LateToTheGame16/InGameNES/ingameNES_back.png

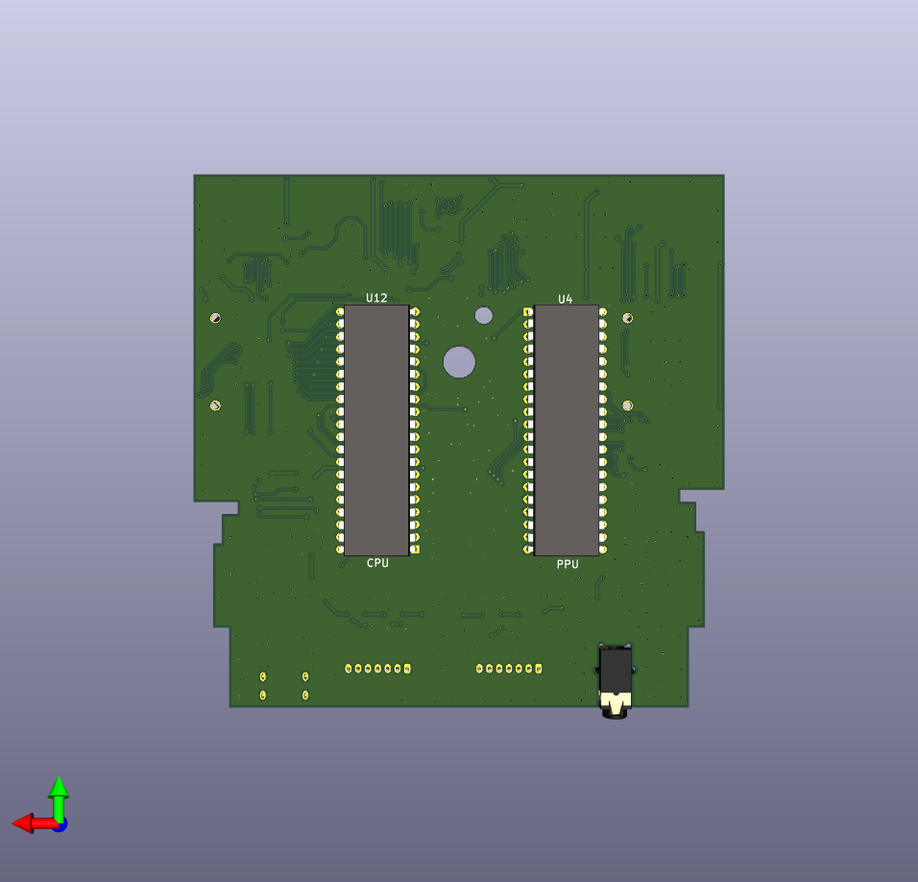
ingameNES_back.png
