LateToTheGame16/InGameNES/ingameNES.png

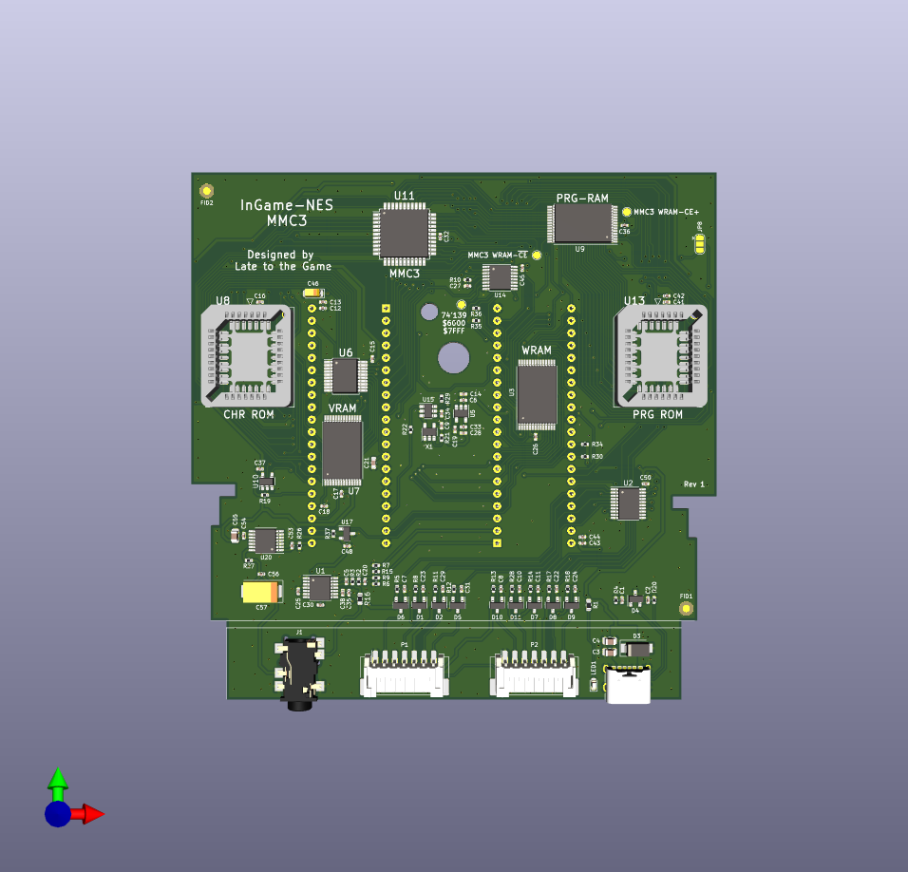
ingameNES.png
