LateToTheGame16/InGameNES/README.md

# InGameNES
 NES console that fits in a game cart
