LateToTheGame16/InGameNES/PTS847MM350LSMTR2 LFS.stp

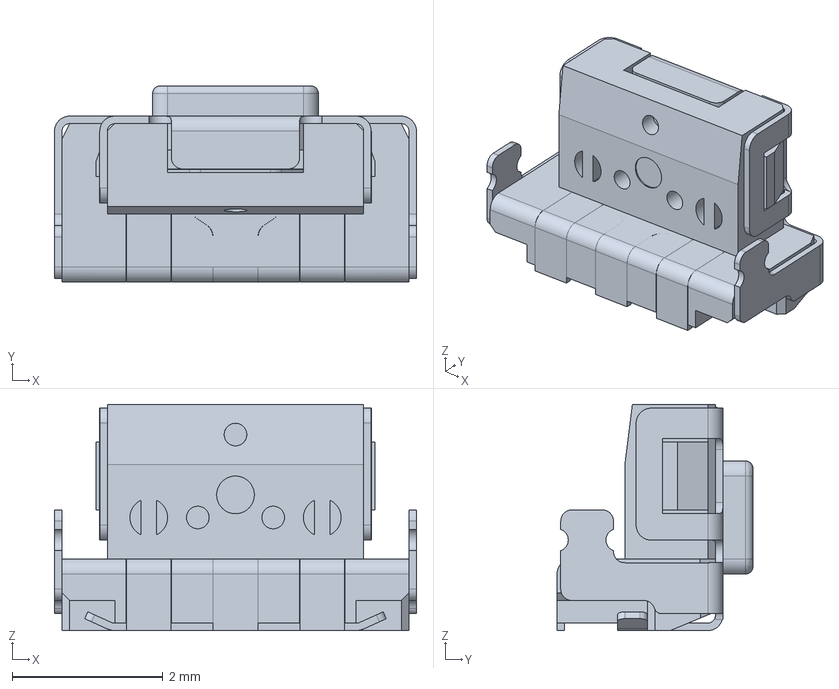
[picture p3: CAD file, 2022-07-29]
PTS847MM350LSMTR2 LFS.stp
4.80 x 2.60 x 3.00 mm
