LateToTheGame16/InGameNES/L_XNH8080YK.STEP

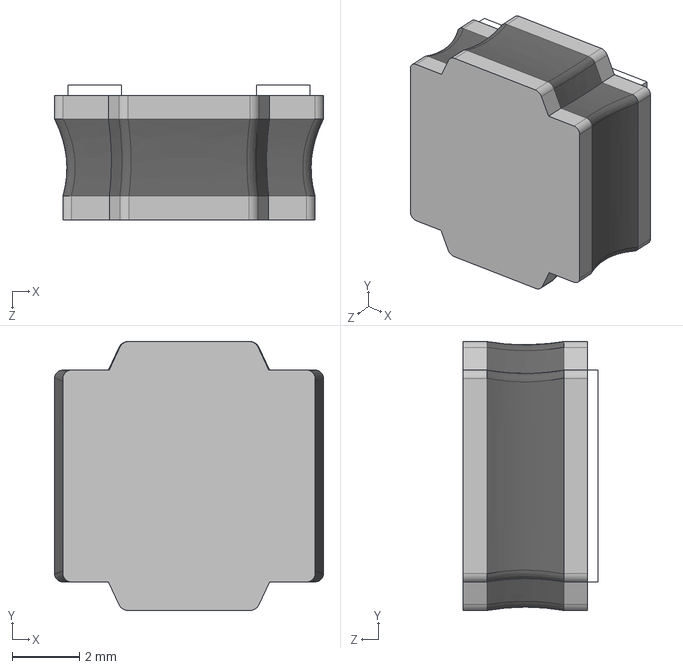
[picture p4: CAD file, 2022-07-29]
L_XNH8080YK.STEP
8.00 x 8.00 x 4.00 mm
