LateToTheGame16/InGameNES/CUI_UJC-HP-3-SMT-TR.step

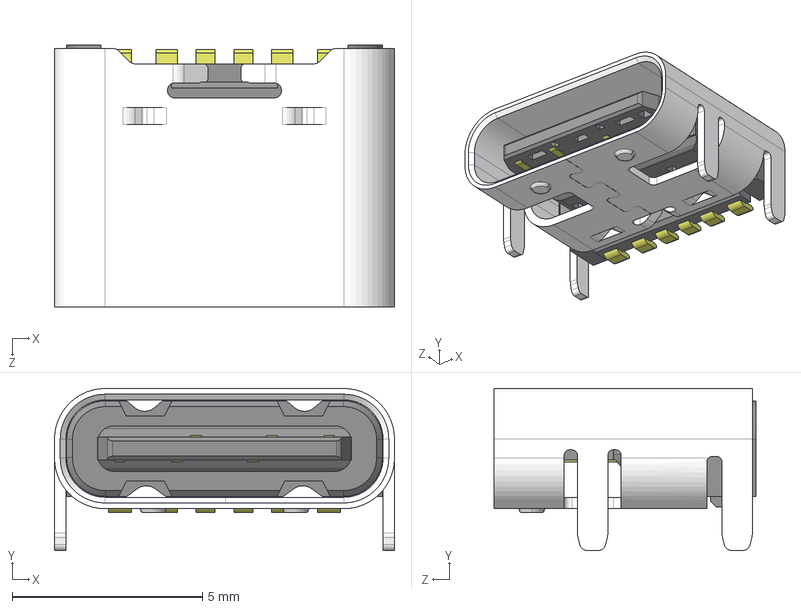
[picture p5: CAD file, 2022-06-28]
CUI_UJC-HP-3-SMT-TR.step
8.94 x 4.26 x 6.90 mm
