LateToTheGame16/InGameNES/8432-21a1-01.stp

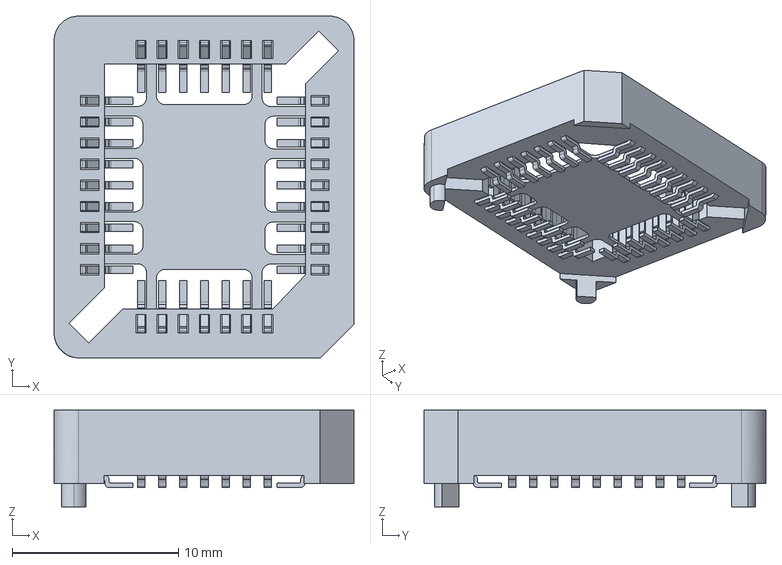
[picture p6: CAD file, 2022-06-28]
8432-21a1-01.stp
18.0 x 20.5 x 5.82 mm
