LateToTheGame16/InGameNES/CUI_DEVICES_SJ-43504-SMT-TR.step

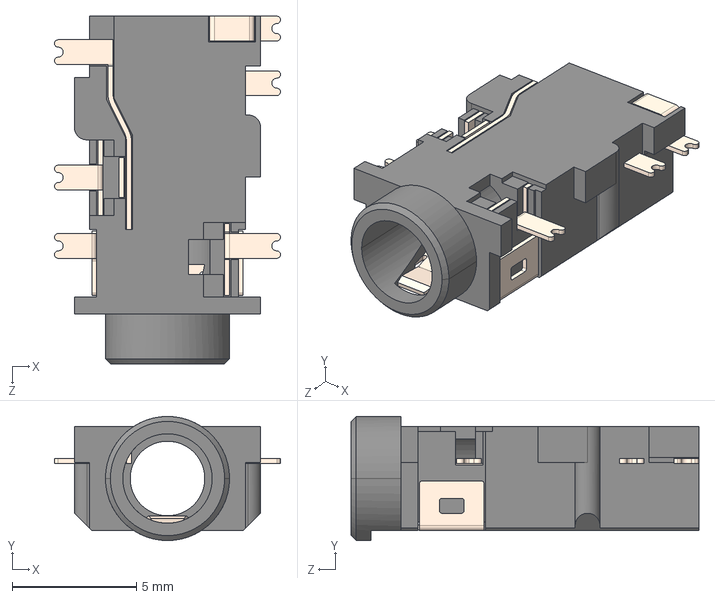
[picture p7: CAD file, 2022-06-28]
CUI_DEVICES_SJ-43504-SMT-TR.step
9.10 x 5.00 x 14.0 mm
