LateToTheGame16/InGameNES/ingameNES.kicad_pcb

## KiCad design ingameNES.kicad_pcb (2022-06-28)

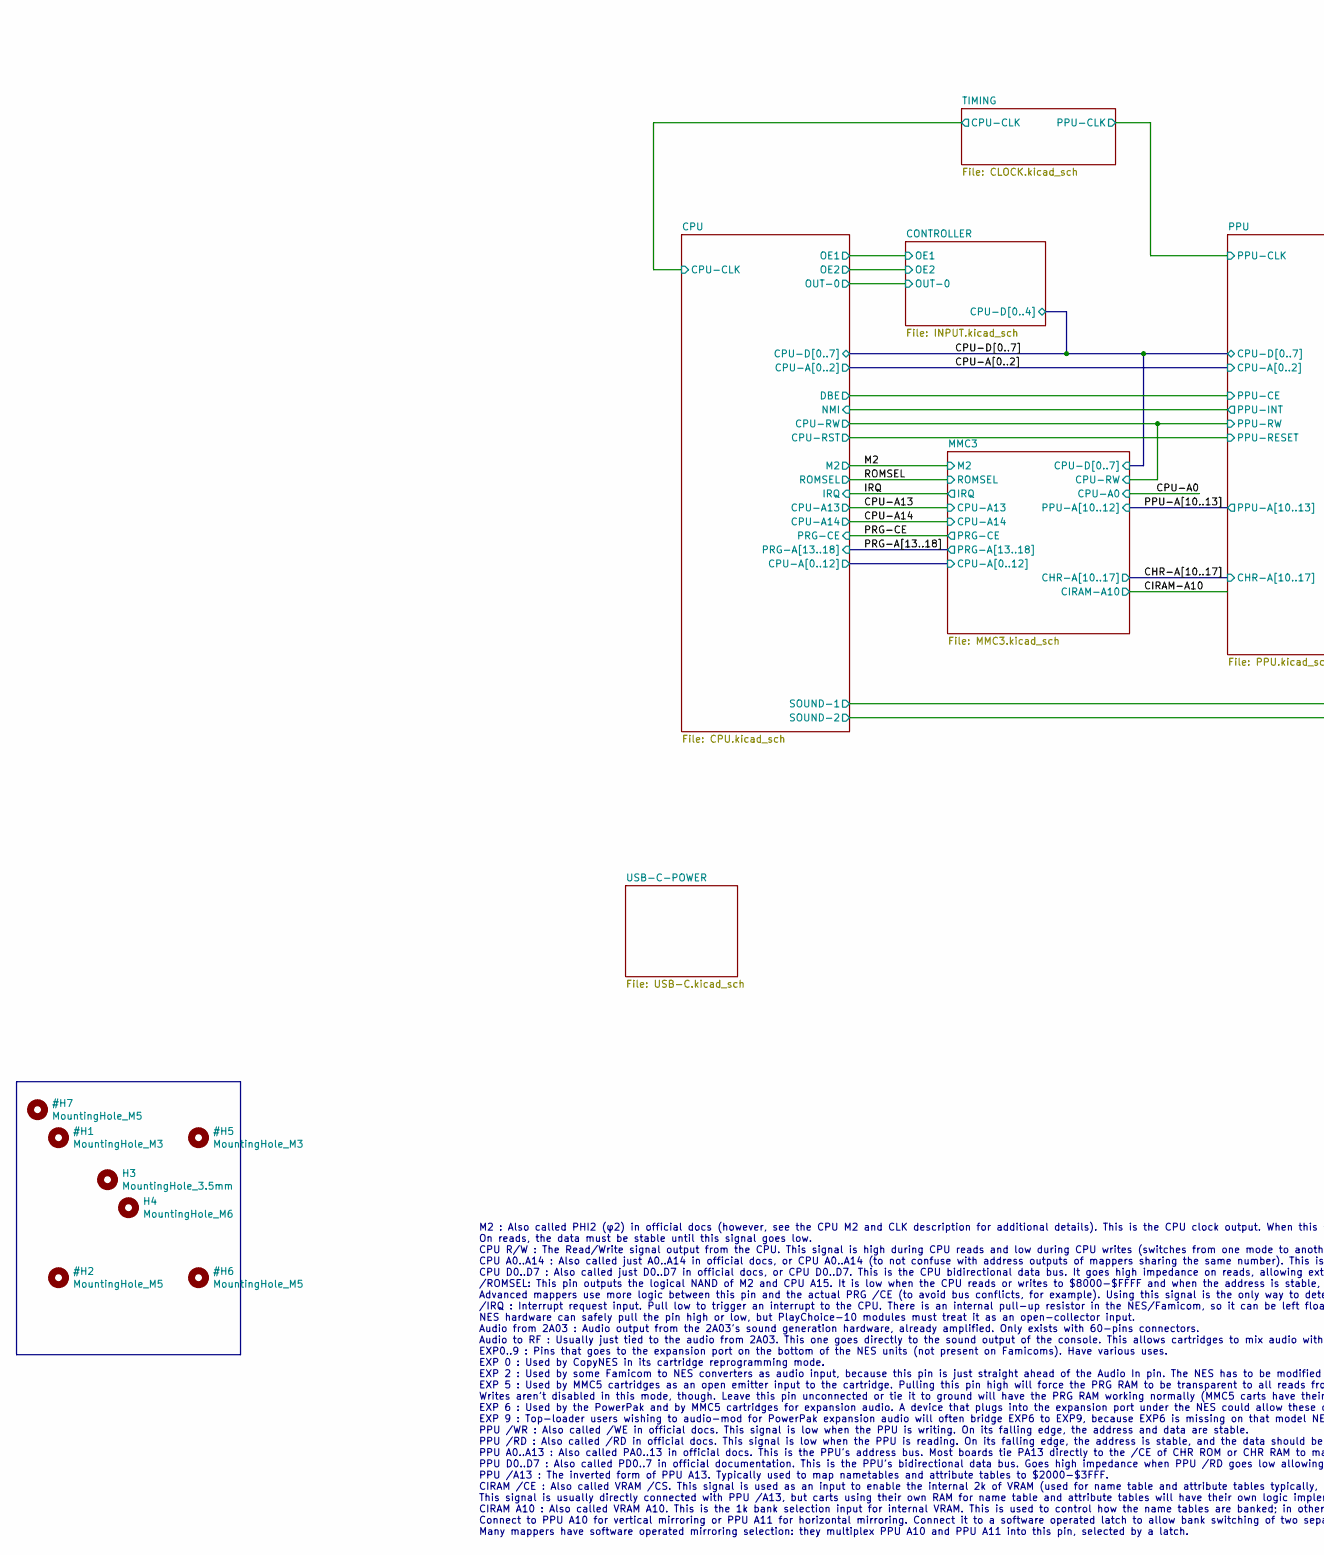
[picture p8: schematic ingameNES.kicad_sch, InGame-NES MMC3, part in row 1, column 1]

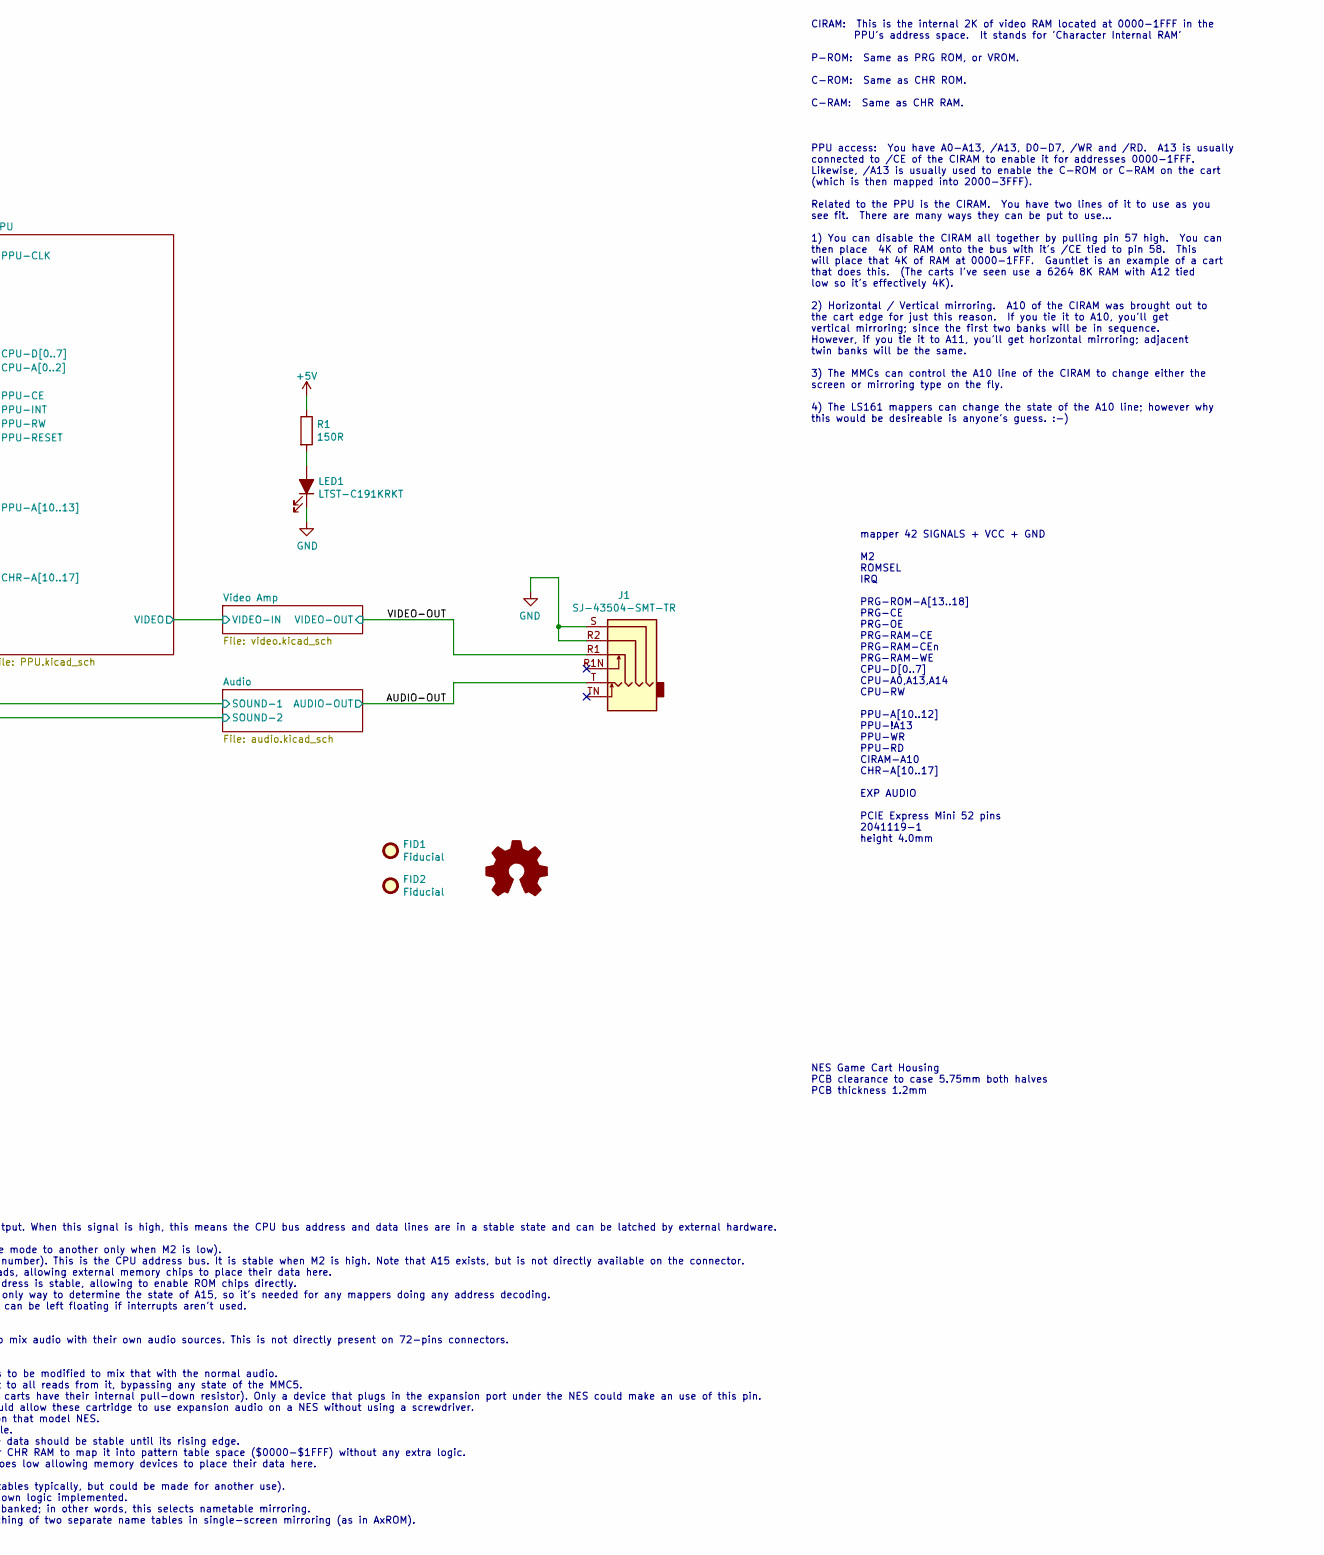
[picture p9: schematic ingameNES.kicad_sch, InGame-NES MMC3, part in row 1, column 2]

Parts:
FID1, FID2: Fiducial; Fiducial_1.5mm_Mask3mm
H3: MountingHole_3.5mm
H4: MountingHole_M6; MountingHole_6.4mm_M6
J1: SJ-43504-SMT-TR; CUI_SJ-43504-SMT-TR; MPN SJ-43504-SMT-TR; Digikey CP-43504SJCT-ND
LED1: LTST-C191KRKT; LED_0603_1608Metric; MPN LTST-C191KRKT; Digikey 160-1447-1-ND
R1: 150R; R_0603_1608Metric; MPN RC0603FR-07150RL; Digikey 311-150HRCT-ND

Connections:
/AUDIO-OUT: J1.T; also elsewhere on the board
/VIDEO-OUT: J1.R1; also elsewhere on the board
unnamed: LED1.2 (A), R1.2

Notes on the sheet:
mapper 42 SIGNALS + VCC + GND M2 ROMSEL IRQ PRG-ROM-A[13..18] PRG-CE PRG-OE PRG-RAM-CE PRG-RAM-CEn PRG-RAM-WE CPU-D[0..7] CPU-A0,A13,A14 CPU-RW PPU-A[10..12] PPU-!A13 PPU-WR PPU-RD CIRAM-A10 CHR-A[10..17] EXP AUDIO PCIE Express Mini 52 pins 2041119-1 height 4.0mm
CIRAM: This is the internal 2K of video RAM located at 0000-1FFF in the PPU's address space. It stands for 'Character Internal RAM' P-ROM: Same as PRG ROM, or VROM. C-ROM: Same as CHR ROM. C-RAM: Same as CHR RAM. PPU access: You have A0-A13, /A13, D0-D7, /WR and /RD. A13 is usually connected to /CE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
M2 : Also called PHI2 (φ2) in official docs (however, see the CPU M2 and CLK description for additional details). This is the CPU clock output. When this signal is high, this means the CPU bus address and data lines are in a stable state and can be latched by external hardware. On reads, the data m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
NES Game Cart Housing PCB clearance to case 5.75mm both halves PCB thickness 1.2mm

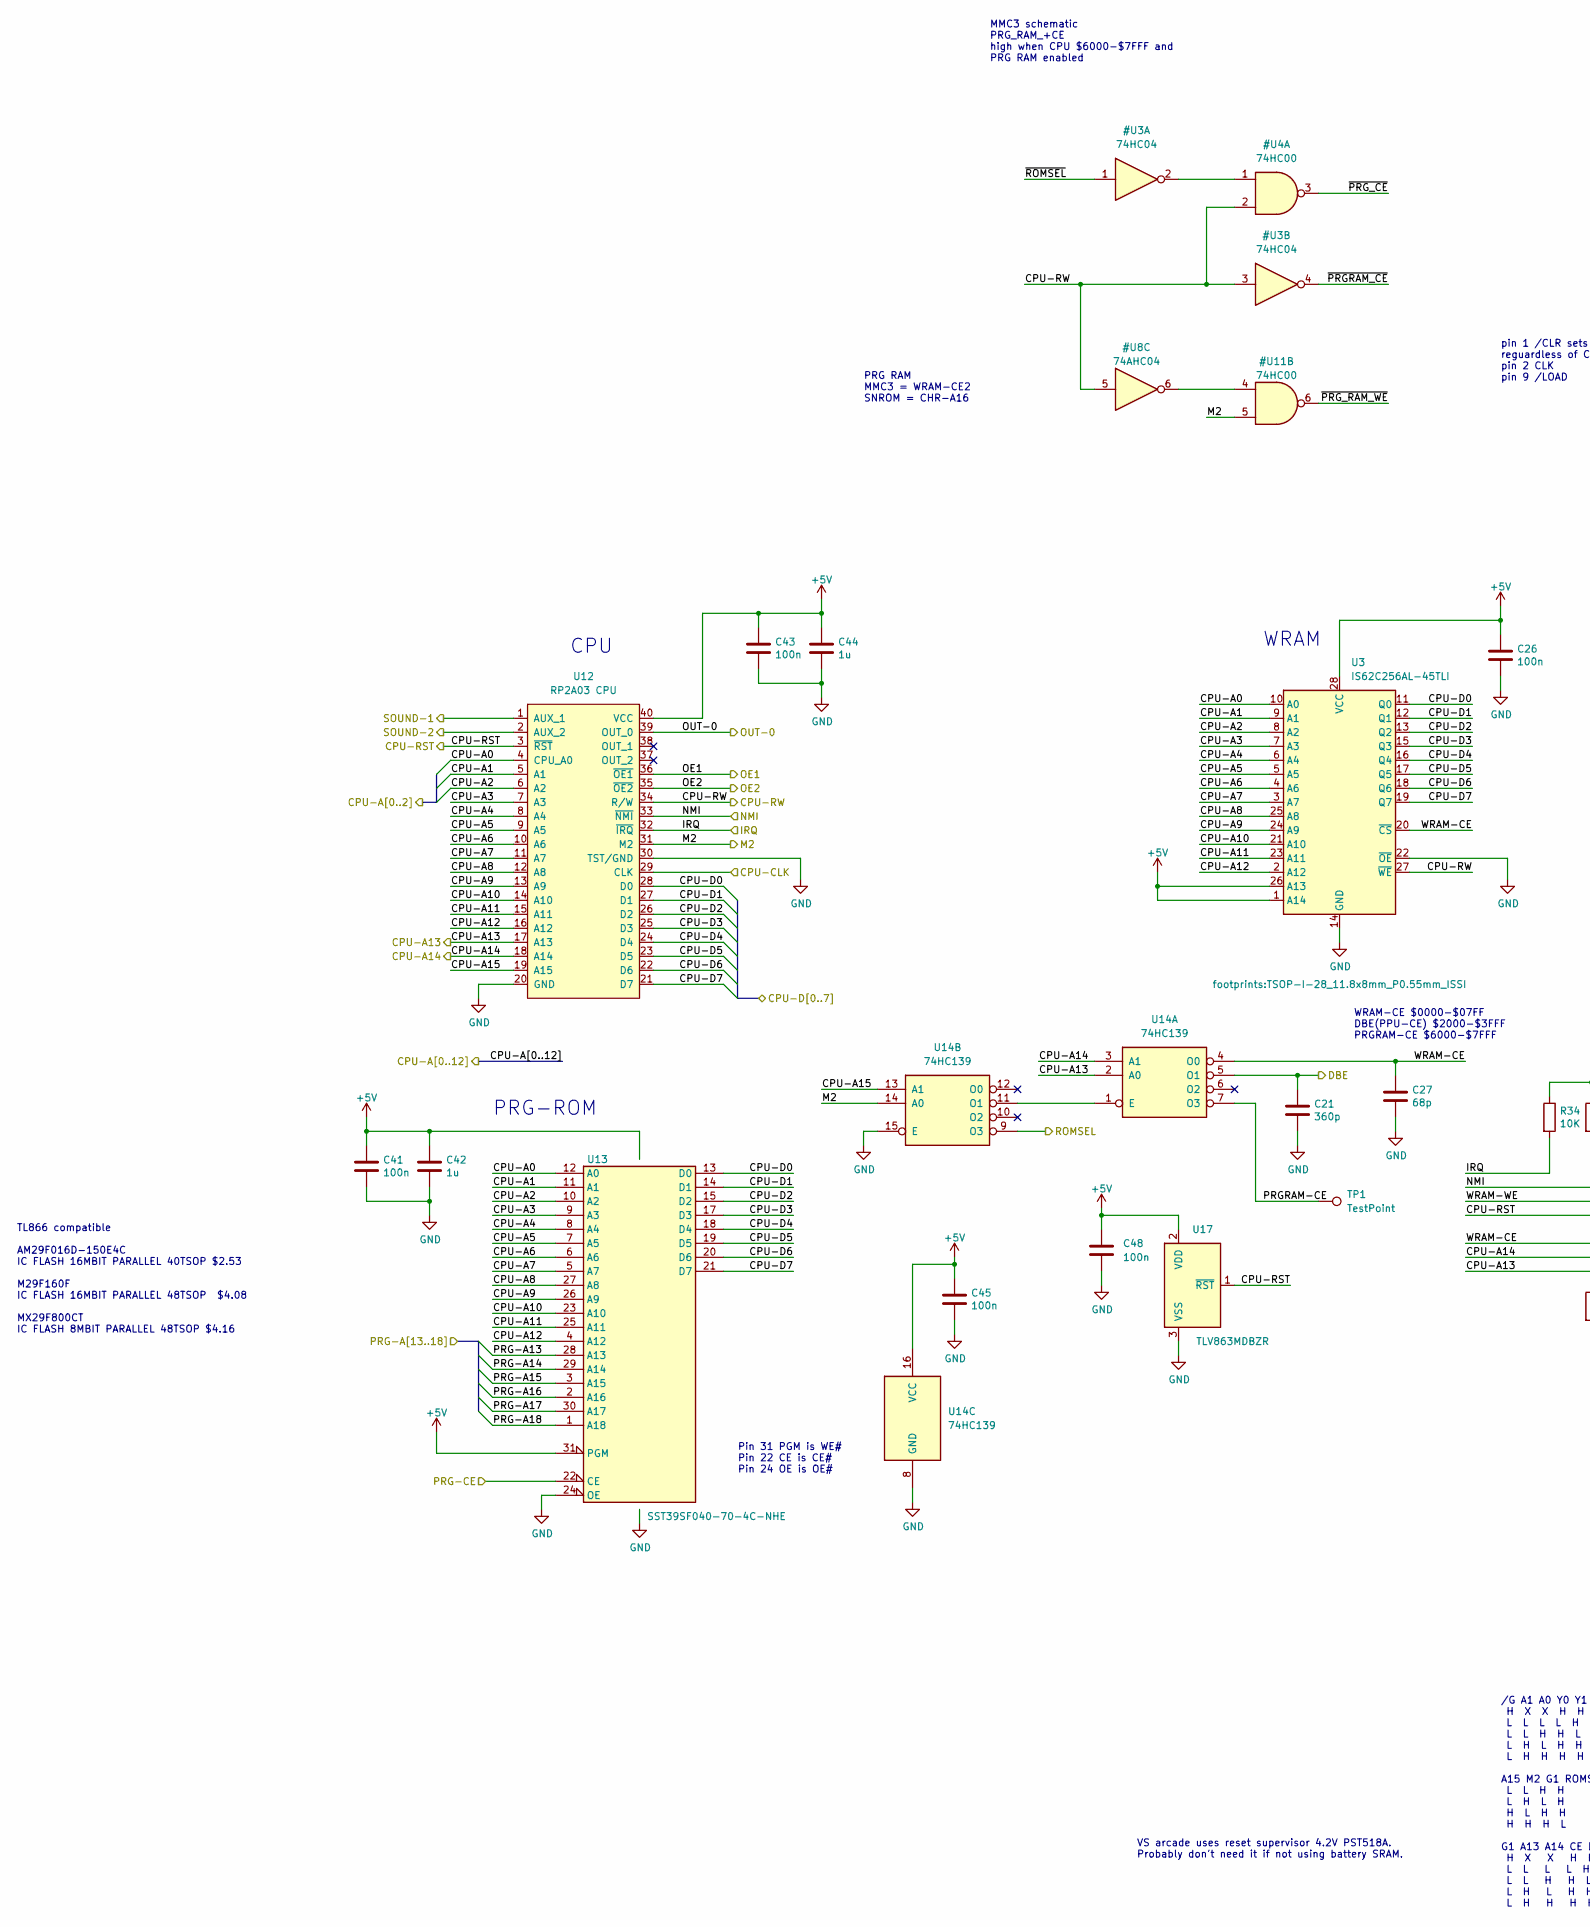
[picture p10: schematic CPU.kicad_sch, InGame-NES MMC3, part in row 1, column 1]

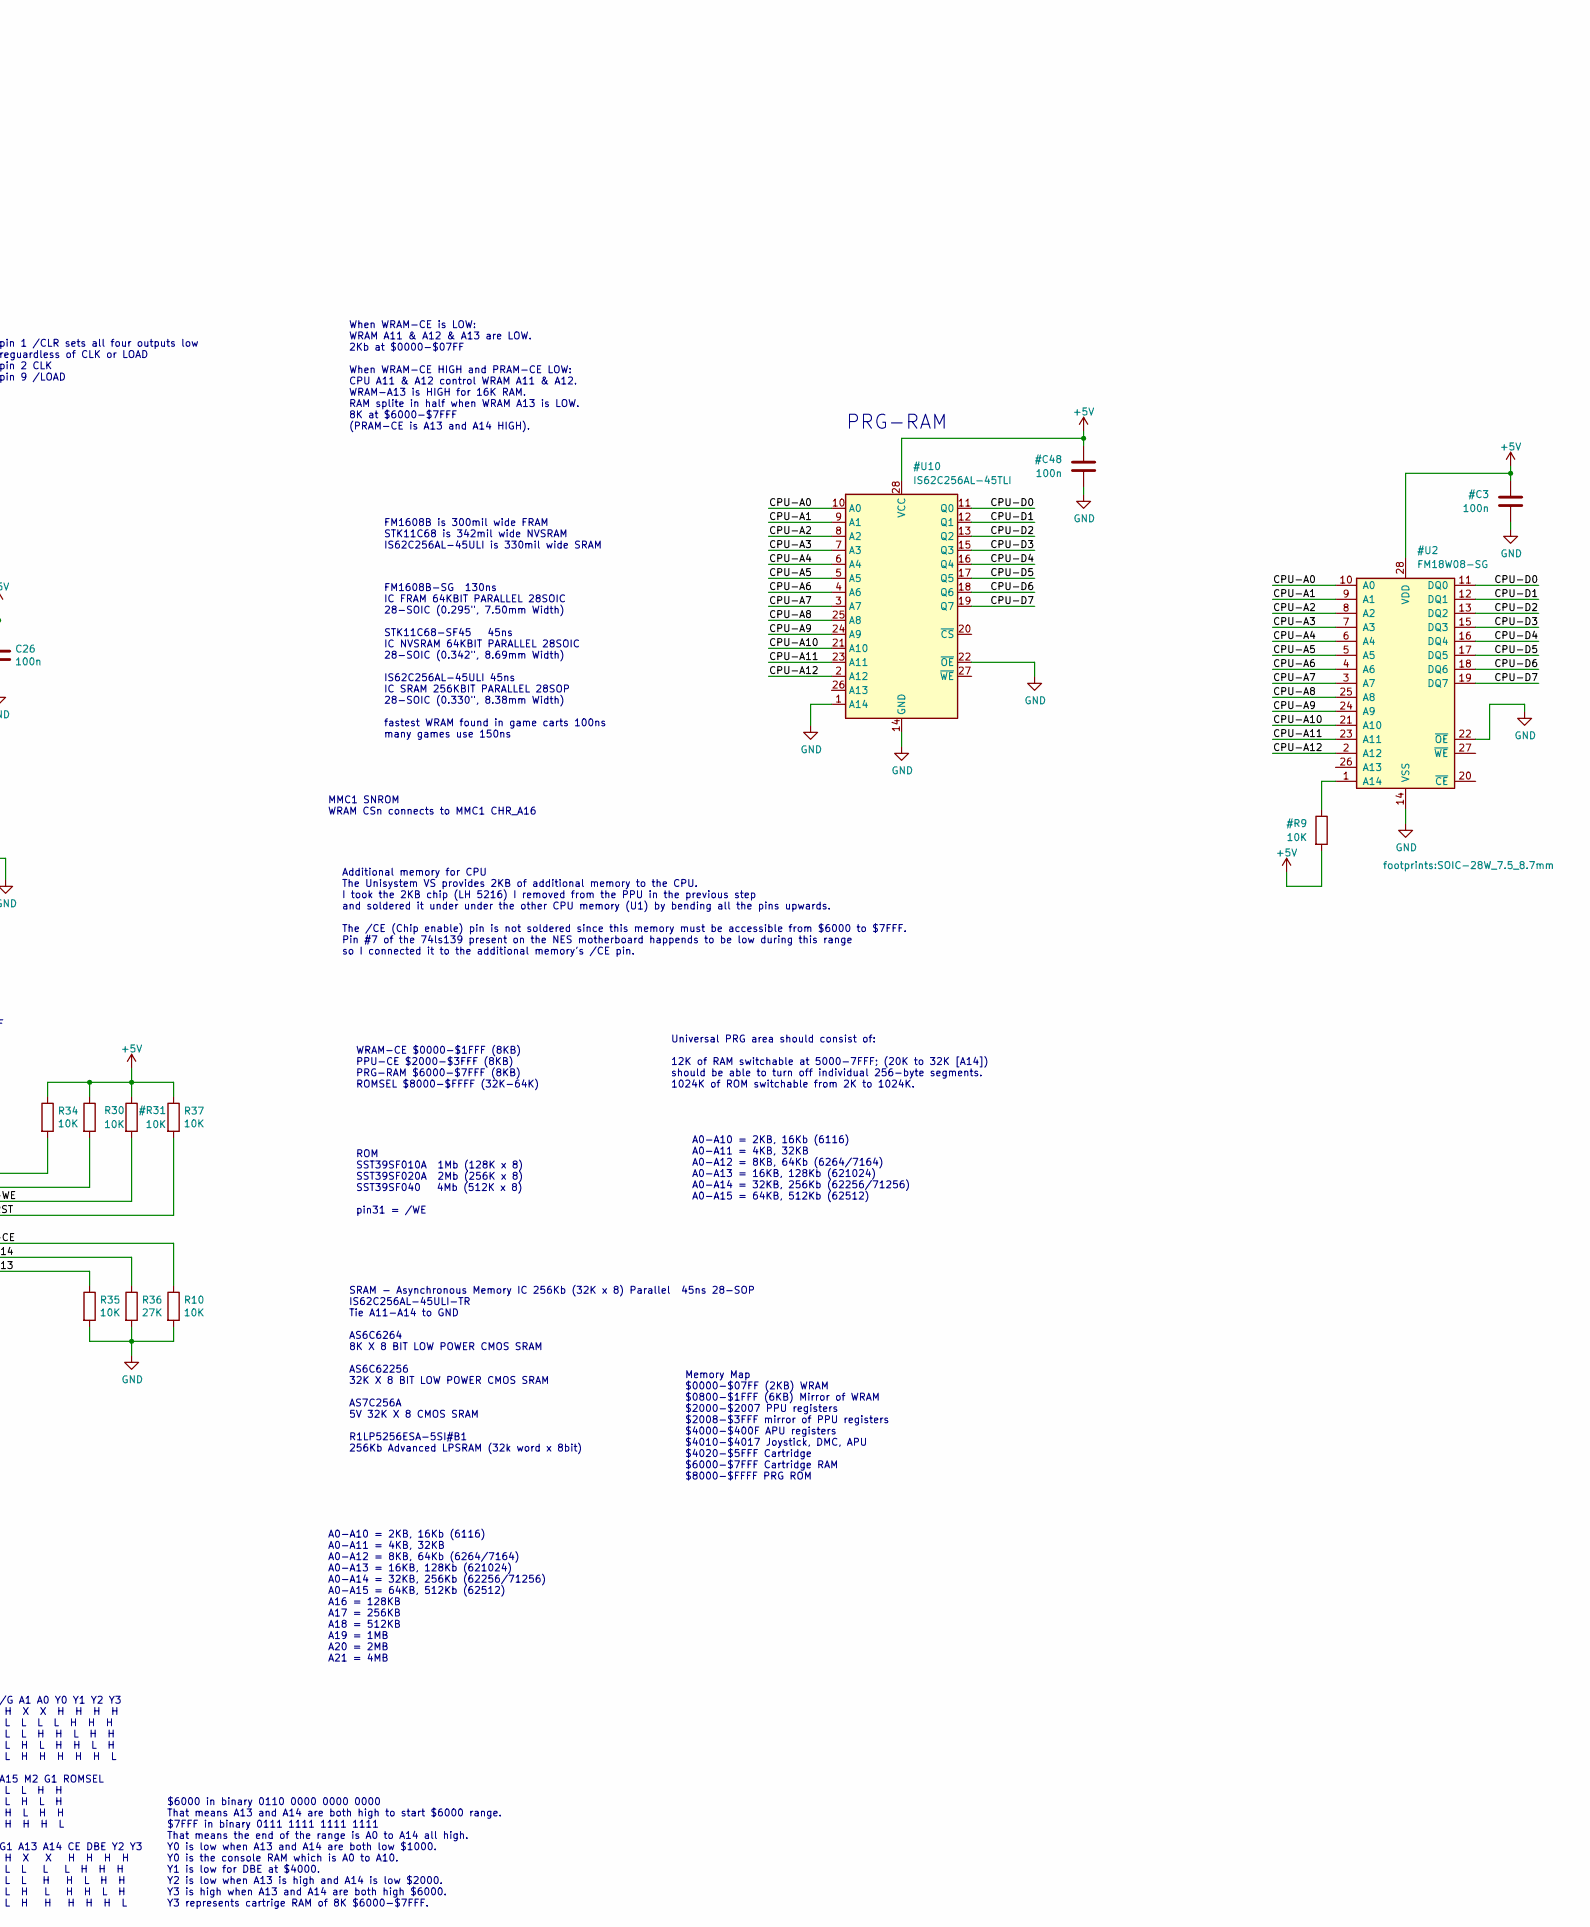
[picture p11: schematic CPU.kicad_sch, InGame-NES MMC3, part in row 1, column 2]

Parts:
C21: 360p; C_0603_1608Metric; MPN C0603C361J5GAC7867; Digikey 399-15397-1-ND
C26, C41, C43, C45, C48: 100n; C_0402_1005Metric; MPN CL05B104KO5NNWC; Digikey 1276-1509-2-ND
C27: 68p; C_0402_1005Metric; MPN CC0402JRNPO9BN680; Digikey 311-1340-1-ND
C42, C44: 1u; C_0402_1005Metric; MPN GRM155R61A105KE15D; Digikey 490-3890-2-ND
R10, R30, R34, R35, R37: 10K; R_0402_1005Metric; MPN ERJ-2RKF1002X; Digikey P10.0KLCT-ND
R36: 27K; R_0402_1005Metric; MPN RC0402JR-0727KL; Digikey 311-27KJRCT-ND
TP1: TestPoint; TestPoint_Pad_D1.5mm
U3: IS62C256AL-45TLI; TSOP-I-28_11.8x8mm_P0.55mm_ISSI; MPN IS62C256AL-45TLI; Digikey 706-1109-ND
U12: RP2A03 CPU; DIP-40_W15.24mm; MPN ED40DT; Digikey ED3048-5-ND
U13: SST39SF040-70-4C-NHE; SOCKET-PLCC-32-SMD; MPN SST39SF040-70-4C-NHE; Digikey SST39SF040-70-4C-NHE-ND
U14: 74HC139; TSSOP-16_4.4x5mm_P0.65mm; MPN SN74HC139PWR; Digikey 296-8231-1-ND
U17: TLV863MDBZR; SOT-23; MPN TLV863MDBZR; Digikey 296-29707-1-ND

Connections:
/Audio/SOUND-1: U12.1 (AUX_1); also elsewhere on the board
/Audio/SOUND-2: U12.2 (AUX_2); also elsewhere on the board
/CONTROLLER/OE1: U12.36 (~OE1); also elsewhere on the board
/CONTROLLER/OE2: U12.35 (~OE2); also elsewhere on the board
/CONTROLLER/OUT-0: U12.39 (OUT_0); also elsewhere on the board
/CPU/CPU-A15: U12.19 (A15), U14.13 (A1)
/CPU/CPU-RST: R37.2, U12.3 (~RST), U17.1 (~RST); also elsewhere on the board
/CPU/DBE: C21.2, U14.5 (O1); also elsewhere on the board
/CPU/NMI: R30.2, U12.33 (~NMI); also elsewhere on the board
/CPU/PRGRAM-CE: TP1.1, U14.7 (O3)
/CPU/WRAM-CE: C27.2, R10.1, U3.20 (~CS), U14.4 (O0)
unnamed: U14.1 (E), U14.11 (O1)

Notes on the sheet:
FM1608B-SG 130ns IC FRAM 64KBIT PARALLEL 28SOIC 28-SOIC (0.295", 7.50mm Width) STK11C68-SF45 45ns IC NVSRAM 64KBIT PARALLEL 28SOIC 28-SOIC (0.342", 8.69mm Width) IS62C256AL-45ULI 45ns IC SRAM 256KBIT PARALLEL 28SOP 28-SOIC (0.330", 8.38mm Width) fastest WRAM found in game carts 100ns many games use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
PRG RAM MMC3 = WRAM-CE2 SNROM = CHR-A16
PRG-ROM
CPU
TL866 compatible AM29F016D-150E4C IC FLASH 16MBIT PARALLEL 40TSOP $2.53 M29F160F IC FLASH 16MBIT PARALLEL 48TSOP $4.08 MX29F800CT IC FLASH 8MBIT PARALLEL 48TSOP $4.16
pin 1 /CLR sets all four outputs low reguardless of CLK or LOAD pin 2 CLK pin 9 /LOAD
Additional memory for CPU The Unisystem VS provides 2KB of additional memory to the CPU. I took the 2KB chip (LH 5216) I removed from the PPU in the previous step and soldered it under under the other CPU memory (U1) by bending all the pins upwards. The /CE (Chip enable) pin is not soldered since t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
ROM SST39SF010A 1Mb (128K x 8) SST39SF020A 2Mb (256K x 8) SST39SF040 4Mb (512K x 8) pin31 = /WE
Memory Map $0000-$07FF (2KB) WRAM $0800-$1FFF (6KB) Mirror of WRAM $2000-$2007 PPU registers $2008-$3FFF mirror of PPU registers $4000-$400F APU registers $4010-$4017 Joystick, DMC, APU $4020-$5FFF Cartridge $6000-$7FFF Cartridge RAM $8000-$FFFF PRG ROM
Pin 31 PGM is WE# Pin 22 CE is CE# Pin 24 OE is OE#
VS arcade uses reset supervisor 4.2V PST518A. Probably don't need it if not using battery SRAM.
PRG-RAM
Universal PRG area should consist of: 12K of RAM switchable at 5000-7FFF; (20K to 32K [A14]) should be able to turn off individual 256-byte segments. 1024K of ROM switchable from 2K to 1024K.
WRAM-CE $0000-$07FF DBE(PPU-CE) $2000-$3FFF PRGRAM-CE $6000-$7FFF
$6000 in binary 0110 0000 0000 0000 That means A13 and A14 are both high to start $6000 range. $7FFF in binary 0111 1111 1111 1111 That means the end of the range is A0 to A14 all high. Y0 is low when A13 and A14 are both low $1000. Y0 is the console RAM which is A0 to A10. Y1 is low for DBE at $40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
When WRAM-CE is LOW: WRAM A11 & A12 & A13 are LOW. 2Kb at $0000-$07FF When WRAM-CE HIGH and PRAM-CE LOW: CPU A11 & A12 control WRAM A11 & A12. WRAM-A13 is HIGH for 16K RAM. RAM splite in half when WRAM A13 is LOW. 8K at $6000-$7FFF (PRAM-CE is A13 and A14 HIGH).
WRAM
SRAM - Asynchronous Memory IC 256Kb (32K x 8) Parallel 45ns 28-SOP IS62C256AL-45ULI-TR Tie A11-A14 to GND AS6C6264 8K X 8 BIT LOW POWER CMOS SRAM AS6C62256 32K X 8 BIT LOW POWER CMOS SRAM AS7C256A 5V 32K X 8 CMOS SRAM R1LP5256ESA-5SI#B1 256Kb Advanced LPSRAM (32k word x 8bit)
MMC3 schematic PRG_RAM_+CE high when CPU $6000-$7FFF and PRG RAM enabled
FM1608B is 300mil wide FRAM STK11C68 is 342mil wide NVSRAM IS62C256AL-45ULI is 330mil wide SRAM
WRAM-CE $0000-$1FFF (8KB) PPU-CE $2000-$3FFF (8KB) PRG-RAM $6000-$7FFF (8KB) ROMSEL $8000-$FFFF (32K-64K)
/G A1 A0 Y0 Y1 Y2 Y3 H X X H H H H L L L L H H H L L H H L H H L H L H H L H L H H H H H L A15 M2 G1 ROMSEL L L H H L H L H H L H H H H H L G1 A13 A14 CE DBE Y2 Y3 H X X H H H H L L L L H H H L L H H L H H L H L H H L H L H H H H H L
A0-A10 = 2KB, 16Kb (6116) A0-A11 = 4KB, 32KB A0-A12 = 8KB, 64Kb (6264/7164) A0-A13 = 16KB, 128Kb (621024) A0-A14 = 32KB, 256Kb (62256/71256) A0-A15 = 64KB, 512Kb (62512) A16 = 128KB A17 = 256KB A18 = 512KB A19 = 1MB A20 = 2MB A21 = 4MB
A0-A10 = 2KB, 16Kb (6116) A0-A11 = 4KB, 32KB A0-A12 = 8KB, 64Kb (6264/7164) A0-A13 = 16KB, 128Kb (621024) A0-A14 = 32KB, 256Kb (62256/71256) A0-A15 = 64KB, 512Kb (62512)
MMC1 SNROM WRAM CSn connects to MMC1 CHR_A16

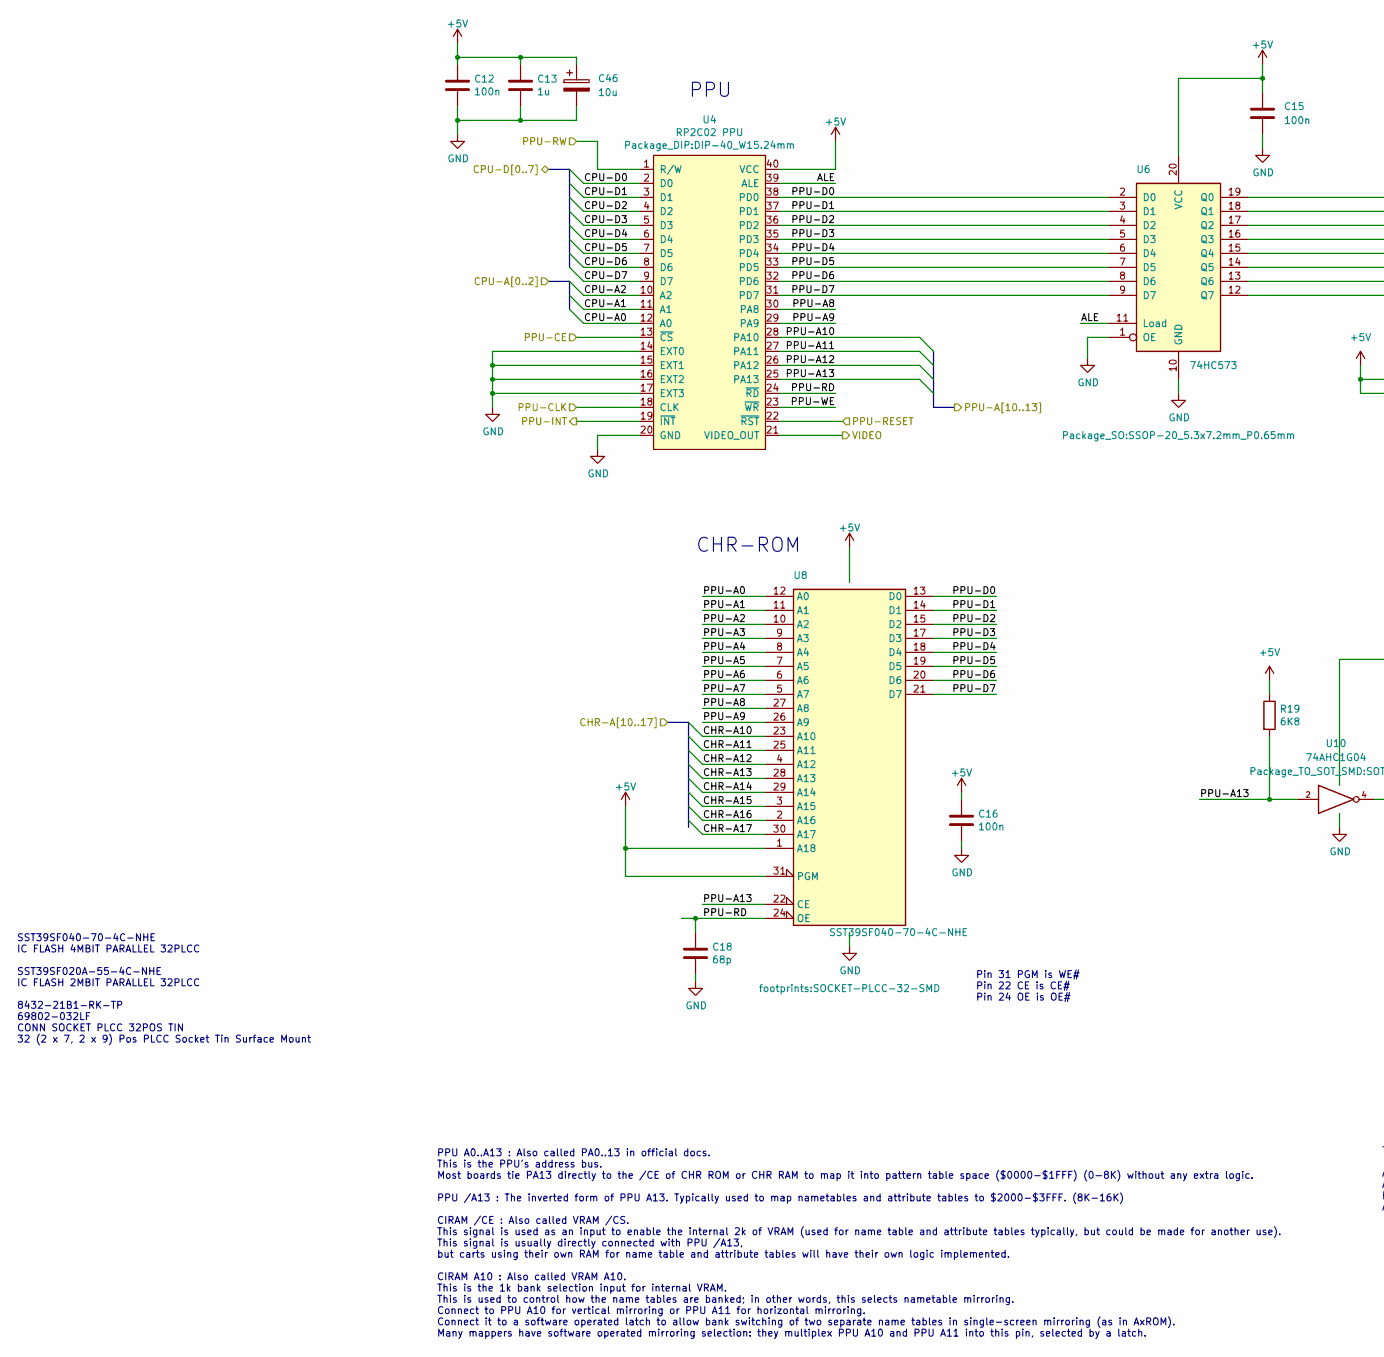
[picture p12: schematic PPU.kicad_sch, InGame-NES MMC3, part in row 1, column 1]

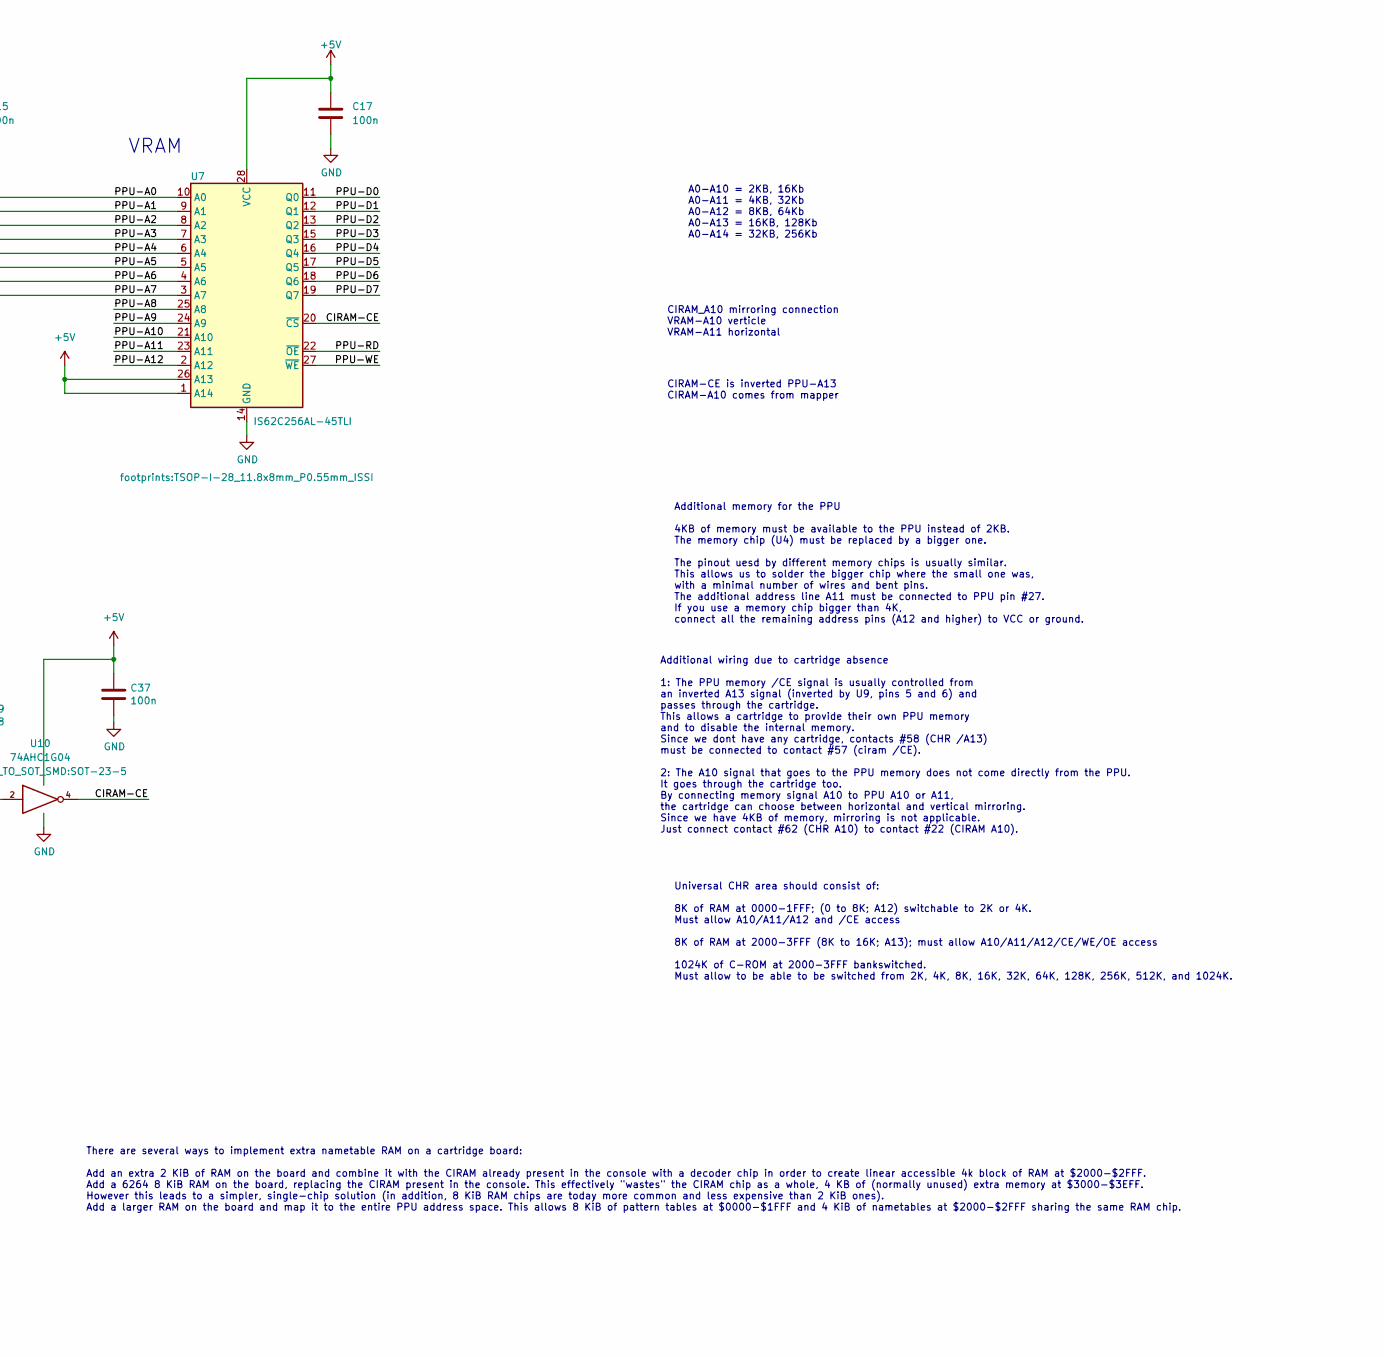
[picture p13: schematic PPU.kicad_sch, InGame-NES MMC3, part in row 1, column 2]

Parts:
C12, C15, C16, C17, C37: 100n; C_0402_1005Metric; MPN CL05B104KO5NNWC; Digikey 1276-1509-2-ND
C13: 1u; C_0402_1005Metric; MPN GRM155R61A105KE15D; Digikey 490-3890-2-ND
C18: 68p; C_0402_1005Metric; MPN CC0402JRNPO9BN680; Digikey 311-1340-1-ND
C46: 10u; CP_EIA-3216-18_Kemet-A; MPN T491A106K010AT; Digikey 399-3684-1-ND
R19: 6K8; R_0402_1005Metric; MPN RC0402FR-076K8L; Digikey 311-6.80KLRCT-ND
U4: RP2C02 PPU; DIP-40_W15.24mm; MPN ED40DT; Digikey ED3048-5-ND
U6: 74HC573; SSOP-20_5.3x7.2mm_P0.65mm; MPN SN74HC573ADBR; Digikey 296-SN74HC573ADBRCT-ND
U7: IS62C256AL-45TLI; TSOP-I-28_11.8x8mm_P0.55mm_ISSI; MPN IS62C256AL-45TLI; Digikey 706-1109-ND
U8: SST39SF040-70-4C-NHE; SOCKET-PLCC-32-SMD; MPN SST39SF040-70-4C-NHE; Digikey SST39SF040-70-4C-NHE-ND
U10: 74AHC1G04; SOT-23-5; MPN SN74AHC1G04DBVR; Digikey 296-1089-1-ND

Connections:
/CPU/CPU-RST: U4.22 (~RST); also elsewhere on the board
/CPU/DBE: U4.13 (~CS); also elsewhere on the board
/CPU/NMI: U4.19 (~INT); also elsewhere on the board
/PPU-A13: R19.2, U4.25 (PA13), U8.22 (CE), U10.2
/PPU/ALE: U4.39 (ALE), U6.11 (Load)
/PPU/CIRAM-CE: U7.20 (~CS), U10.4
/PPU/PPU-A0: U6.19 (Q0), U7.10 (A0), U8.12 (A0)
/PPU/PPU-A1: U6.18 (Q1), U7.9 (A1), U8.11 (A1)
/PPU/PPU-A2: U6.17 (Q2), U7.8 (A2), U8.10 (A2)
/PPU/PPU-A3: U6.16 (Q3), U7.7 (A3), U8.9 (A3)
/PPU/PPU-A4: U6.15 (Q4), U7.6 (A4), U8.8 (A4)
/PPU/PPU-A5: U6.14 (Q5), U7.5 (A5), U8.7 (A5)
/PPU/PPU-A6: U6.13 (Q6), U7.4 (A6), U8.6 (A6)
/PPU/PPU-A7: U6.12 (Q7), U7.3 (A7), U8.5 (A7)
/PPU/PPU-A8: U4.30 (PA8), U7.25 (A8), U8.27 (A8)
/PPU/PPU-A9: U4.29 (PA9), U7.24 (A9), U8.26 (A9)
/PPU/PPU-D0: U4.38 (PD0), U6.2 (D0), U7.11 (Q0), U8.13 (D0)
/PPU/PPU-D1: U4.37 (PD1), U6.3 (D1), U7.12 (Q1), U8.14 (D1)
/PPU/PPU-D2: U4.36 (PD2), U6.4 (D2), U7.13 (Q2), U8.15 (D2)
/PPU/PPU-D3: U4.35 (PD3), U6.5 (D3), U7.15 (Q3), U8.17 (D3)
/PPU/PPU-D4: U4.34 (PD4), U6.6 (D4), U7.16 (Q4), U8.18 (D4)
/PPU/PPU-D5: U4.33 (PD5), U6.7 (D5), U7.17 (Q5), U8.19 (D5)
/PPU/PPU-D6: U4.32 (PD6), U6.8 (D6), U7.18 (Q6), U8.20 (D6)
/PPU/PPU-D7: U4.31 (PD7), U6.9 (D7), U7.19 (Q7), U8.21 (D7)
/PPU/PPU-RD: C18.2, U4.24 (~RD), U7.22 (~OE), U8.24 (OE)
/PPU/PPU-WE: U4.23 (~WR), U7.27 (~WE)
/PPU/VIDEO: U4.21 (VIDEO_OUT); also elsewhere on the board

Notes on the sheet:
SST39SF040-70-4C-NHE IC FLASH 4MBIT PARALLEL 32PLCC SST39SF020A-55-4C-NHE IC FLASH 2MBIT PARALLEL 32PLCC 8432-21B1-RK-TP 69802-032LF CONN SOCKET PLCC 32POS TIN 32 (2 x 7, 2 x 9) Pos PLCC Socket Tin Surface Mount
A0-A10 = 2KB, 16Kb A0-A11 = 4KB, 32Kb A0-A12 = 8KB, 64Kb A0-A13 = 16KB, 128Kb A0-A14 = 32KB, 256Kb
Additional wiring due to cartridge absence 1: The PPU memory /CE signal is usually controlled from an inverted A13 signal (inverted by U9, pins 5 and 6) and passes through the cartridge. This allows a cartridge to provide their own PPU memory and to disable the internal memory. Since we dont have a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
CIRAM_A10 mirroring connection VRAM-A10 verticle VRAM-A11 horizontal
Additional memory for the PPU 4KB of memory must be available to the PPU instead of 2KB. The memory chip (U4) must be replaced by a bigger one. The pinout uesd by different memory chips is usually similar. This allows us to solder the bigger chip where the small one was, with a minimal number of wi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
CHR-ROM
Universal CHR area should consist of: 8K of RAM at 0000-1FFF; (0 to 8K; A12) switchable to 2K or 4K. Must allow A10/A11/A12 and /CE access 8K of RAM at 2000-3FFF (8K to 16K; A13); must allow A10/A11/A12/CE/WE/OE access 1024K of C-ROM at 2000-3FFF bankswitched. Must allow to be able to be switched f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
PPU A0..A13 : Also called PA0..13 in official docs. This is the PPU's address bus. Most boards tie PA13 directly to the /CE of CHR ROM or CHR RAM to map it into pattern table space ($0000-$1FFF) (0-8K) without any extra logic. PPU /A13 : The inverted form of PPU A13. Typically used to map nametable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
There are several ways to implement extra nametable RAM on a cartridge board: Add an extra 2 KiB of RAM on the board and combine it with the CIRAM already present in the console with a decoder chip in order to create linear accessible 4k block of RAM at $2000-$2FFF. Add a 6264 8 KiB RAM on the boar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
CIRAM-CE is inverted PPU-A13 CIRAM-A10 comes from mapper
PPU
VRAM
Pin 31 PGM is WE# Pin 22 CE is CE# Pin 24 OE is OE#

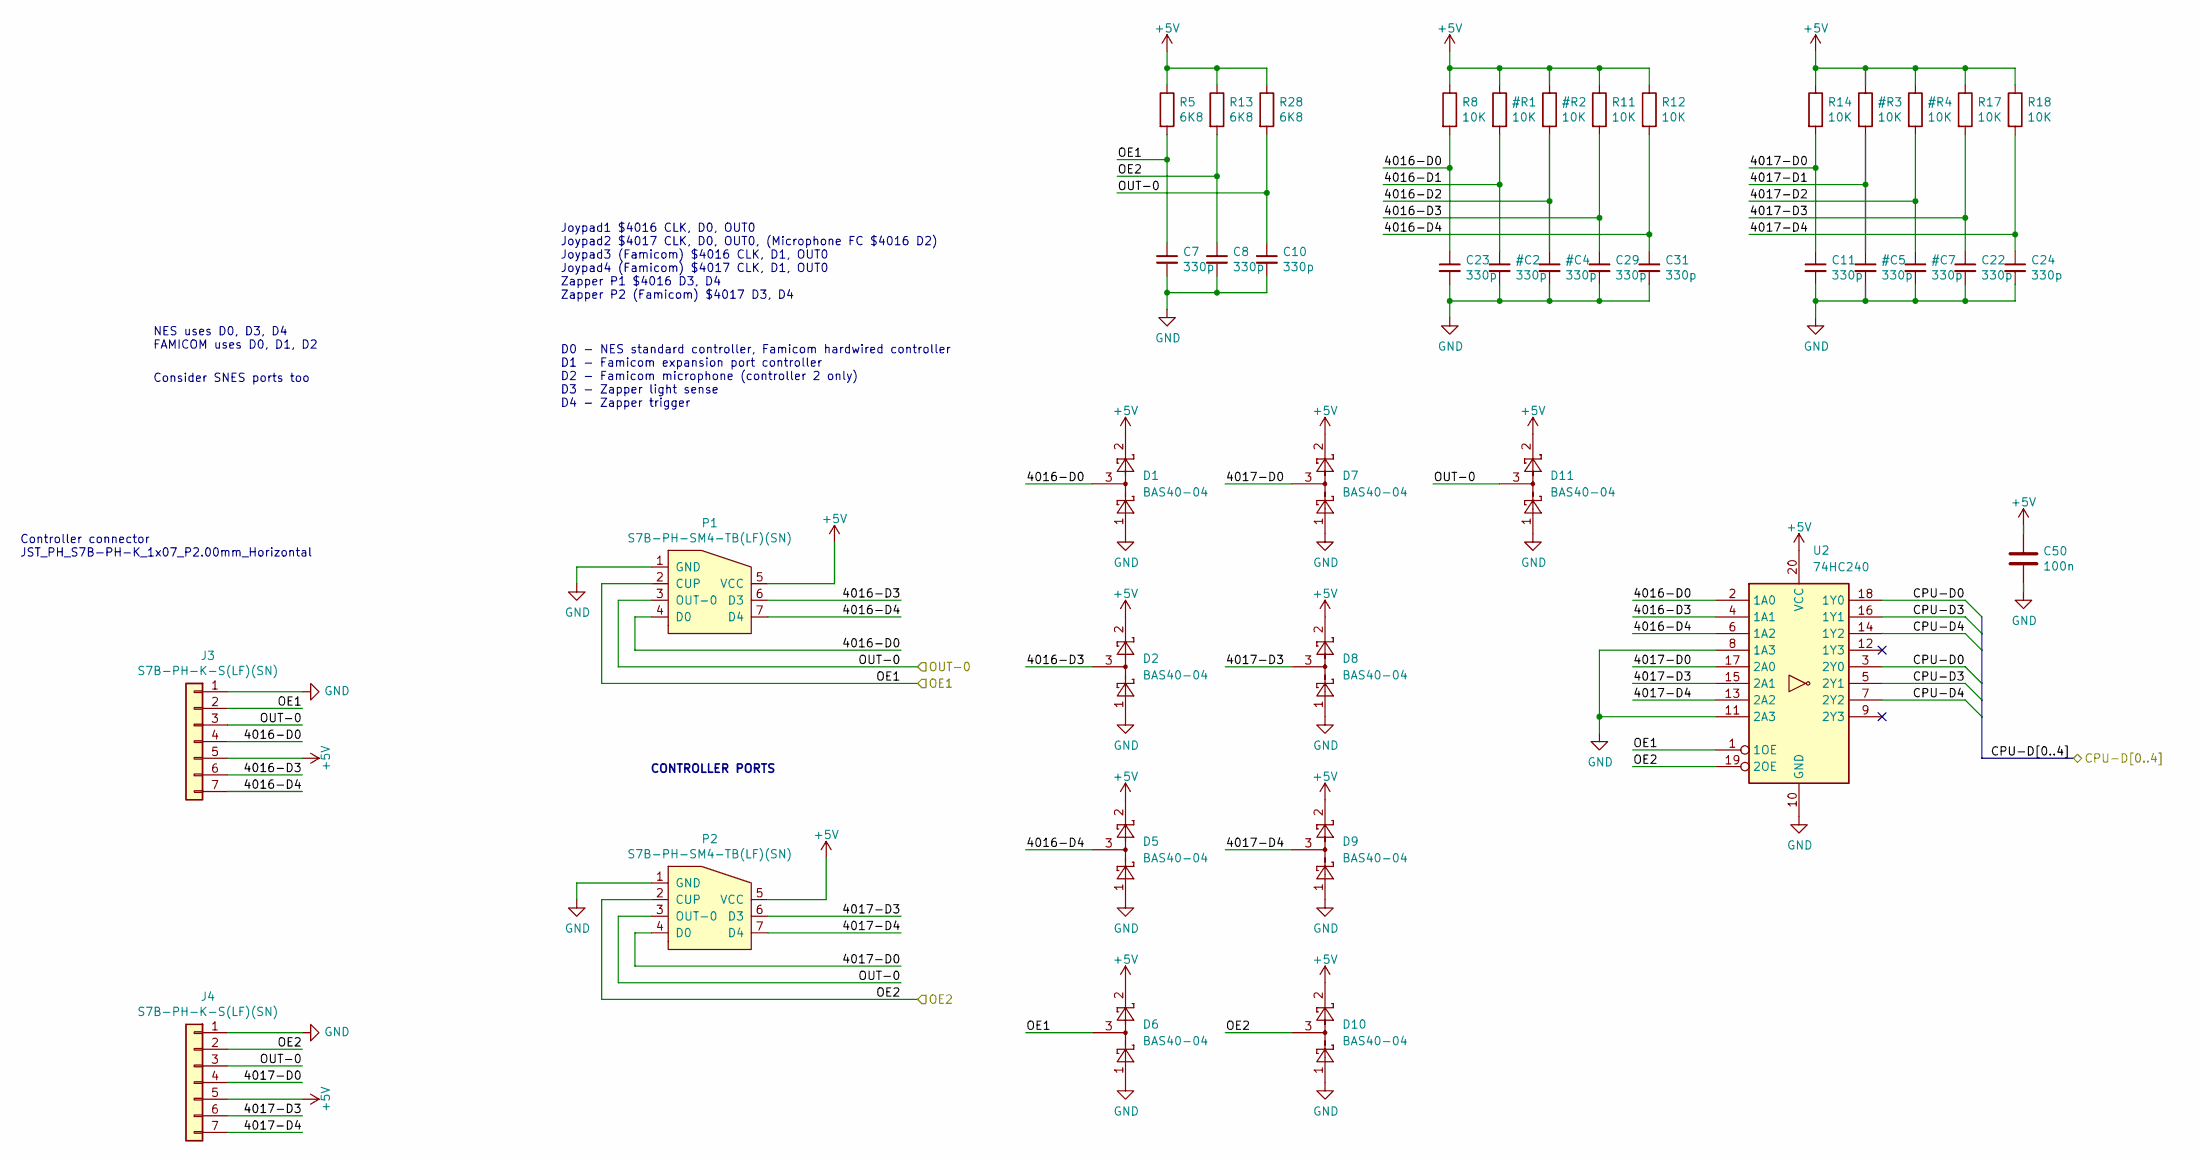
[picture p14: schematic INPUT.kicad_sch, InGame-NES MMC3]

Parts:
C7, C8, C10, C11, C22, C23, C24, C29, C31: 330p; C_0402_1005Metric; MPN 0402N331J500CT; Digikey 1292-1308-1-ND
C50: 100n; C_0402_1005Metric; MPN CL05B104KO5NNWC; Digikey 1276-1509-2-ND
D1, D2, D5, D6, D7, D8, D9, D10, D11: BAS40-04; SOT-23; MPN BAS40-04-TP; Digikey BAS40-04TPMSCT-ND
J3, J4: S7B-PH-K-S(LF)(SN); JST_PH_S7B-PH-K_1x07_P2.00mm_Horizontal; MPN S7B-PH-K-S(LF)(SN); Digikey 455-1724-ND
P1, P2: S7B-PH-SM4-TB(LF)(SN); JST_PH_S7B-PH-SM4-TB_1x07-1MP_P2.00mm_Horizontal; MPN S7B-PH-SM4-TB(LF)(SN); Digikey 455-1754-1-ND
R5, R13, R28: 6K8; R_0402_1005Metric; MPN RC0402FR-076K8L; Digikey 311-6.80KLRCT-ND
R8, R11, R12, R14, R17, R18: 10K; R_0402_1005Metric; MPN ERJ-2RKF1002X; Digikey P10.0KLCT-ND
U2: 74HC240; TSSOP-20_4.4x6.5mm_P0.65mm; MPN SN74HC240PWR; Digikey 296-8269-1-ND

Connections:
/CONTROLLER/4016-D0: C23.1, D1.3, J3.4, P1.4 (D0), R8.2, U2.2 (1A0)
/CONTROLLER/4016-D3: C29.1, D2.3, J3.6, P1.6 (D3), R11.2, U2.4 (1A1)
/CONTROLLER/4016-D4: C31.1, D5.3, J3.7, P1.7 (D4), R12.2, U2.6 (1A2)
/CONTROLLER/4017-D0: C11.1, D7.3, J4.4, P2.4 (D0), R14.2, U2.17 (2A0)
/CONTROLLER/4017-D3: C22.1, D8.3, J4.6, P2.6 (D3), R17.2, U2.15 (2A1)
/CONTROLLER/4017-D4: C24.1, D9.3, J4.7, P2.7 (D4), R18.2, U2.13 (2A2)
/CONTROLLER/OE1: C7.1, D6.3, J3.2, P1.2 (CUP), R5.2, U2.1 (1OE); also elsewhere on the board
/CONTROLLER/OE2: C8.1, D10.3, J4.2, P2.2 (CUP), R13.2, U2.19 (2OE); also elsewhere on the board
/CONTROLLER/OUT-0: C10.1, D11.3, J3.3, J4.3, P1.3 (OUT-0), P2.3 (OUT-0), R28.2; also elsewhere on the board

Notes on the sheet:
Joypad1 $4016 CLK, D0, OUT0 Joypad2 $4017 CLK, D0, OUT0, (Microphone FC $4016 D2) Joypad3 (Famicom) $4016 CLK, D1, OUT0 Joypad4 (Famicom) $4017 CLK, D1, OUT0 Zapper P1 $4016 D3, D4 Zapper P2 (Famicom) $4017 D3, D4
CONTROLLER PORTS
NES uses D0, D3, D4 FAMICOM uses D0, D1, D2
D0 - NES standard controller, Famicom hardwired controller D1 - Famicom expansion port controller D2 - Famicom microphone (controller 2 only) D3 - Zapper light sense D4 - Zapper trigger
Controller connector JST_PH_S7B-PH-K_1x07_P2.00mm_Horizontal
Consider SNES ports too
