LateToTheGame16/InGameNES/ingameNES.kicad_pcb

## KiCad design ingameNES.kicad_pcb (continued)

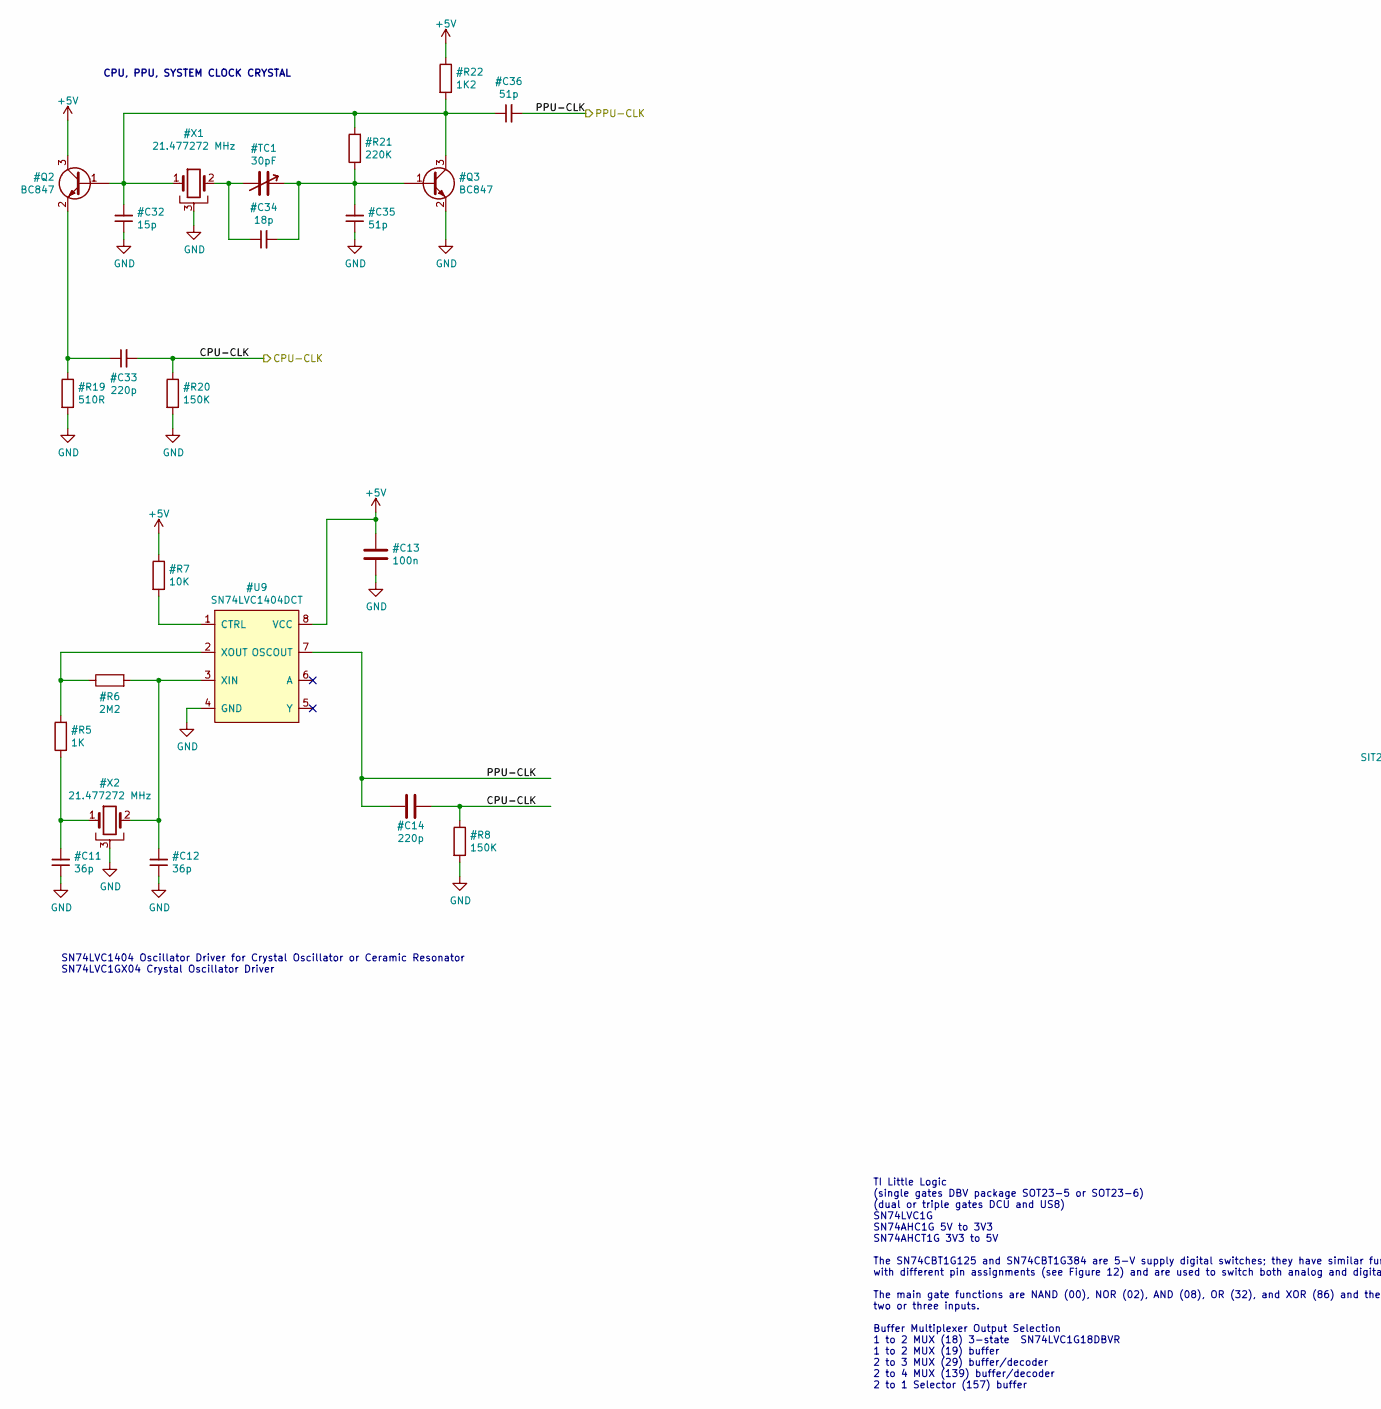
[picture p15: schematic CLOCK.kicad_sch, InGame-NES MMC3, part in row 1, column 1]

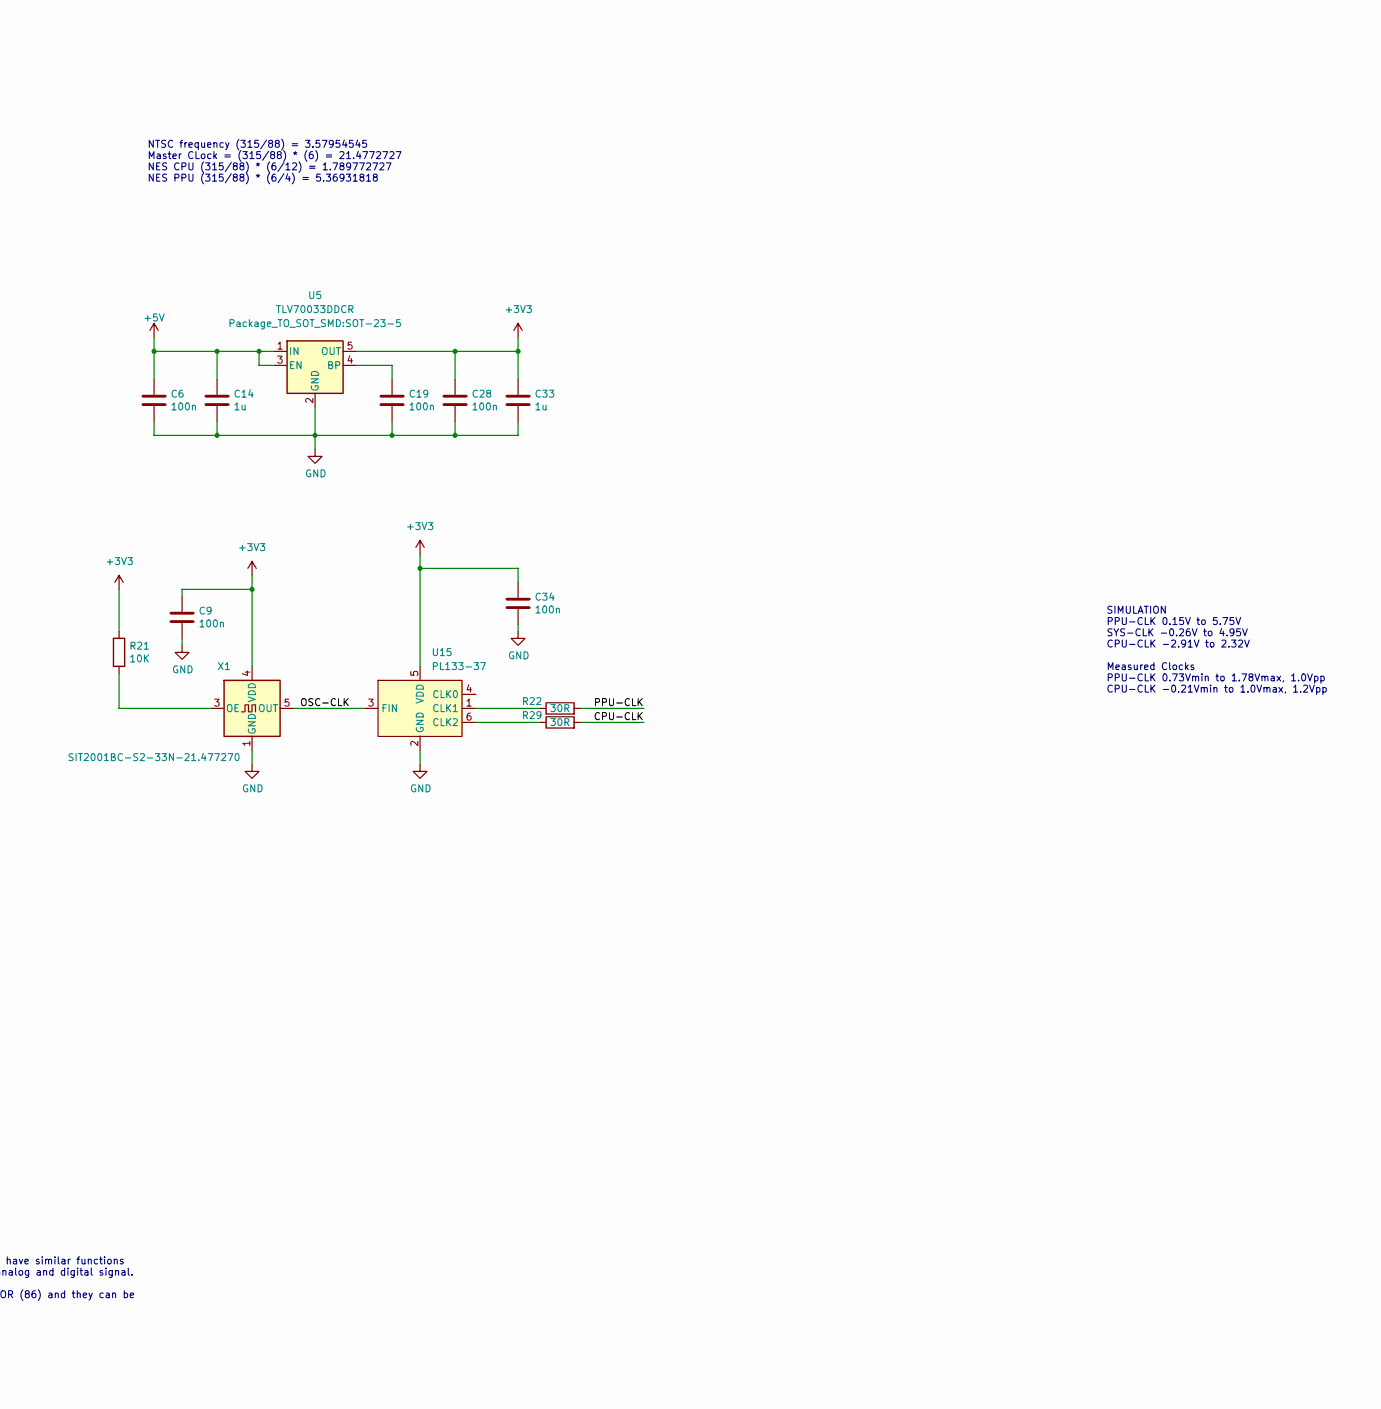
[picture p16: schematic CLOCK.kicad_sch, InGame-NES MMC3, part in row 1, column 2]

Parts:
C6, C9, C19, C28, C34: 100n; C_0402_1005Metric; MPN CL05B104KO5NNWC; Digikey 1276-1509-2-ND
C14, C33: 1u; C_0402_1005Metric; MPN GRM155R61A105KE15D; Digikey 490-3890-2-ND
R21: 10K; R_0402_1005Metric; MPN ERJ-2RKF1002X; Digikey P10.0KLCT-ND
R22, R29: 30R; R_0402_1005Metric; MPN RC0402JR-0730RL; Digikey 311-30JRCT-ND
U5: TLV70033DDCR; SOT-23-5; MPN TLV70033DDCR; Digikey 296-27937-1-ND
U15: PL133-37; SOT-23-6; MPN PL133-37TC; Digikey 576-5036-5-ND
X1: SIT2001BC-S2-33N-21.477270; SOT-23-5; MPN SIT2001BC-S2-33N-21.477270; Digikey 1473-SIT2001BC-S2-33N-21.477270-ND

Connections:
+3V3: C9.2, C28.2, C33.2, C34.2, R21.1, U5.5 (OUT), U15.5 (VDD), X1.4 (VDD)
/TIMING/OSC-CLK: U15.3 (FIN), X1.5 (OUT)
unnamed: C19.2, U5.4 (BP)
unnamed: R21.2, X1.3 (OE)
unnamed: R22.1, U15.1 (CLK1)
unnamed: R29.1, U15.6 (CLK2)

Notes on the sheet:
SIMULATION PPU-CLK 0.15V to 5.75V SYS-CLK -0.26V to 4.95V CPU-CLK -2.91V to 2.32V Measured Clocks PPU-CLK 0.73Vmin to 1.78Vmax, 1.0Vpp CPU-CLK -0.21Vmin to 1.0Vmax, 1.2Vpp
TI Little Logic (single gates DBV package SOT23-5 or SOT23-6) (dual or triple gates DCU and US8) SN74LVC1G SN74AHC1G 5V to 3V3 SN74AHCT1G 3V3 to 5V The SN74CBT1G125 and SN74CBT1G384 are 5-V supply digital switches; they have similar functions with different pin assignments (see Figure 12) and are u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
CPU, PPU, SYSTEM CLOCK CRYSTAL
NTSC frequency (315/88) = 3.57954545 Master CLock = (315/88) * (6) = 21.4772727 NES CPU (315/88) * (6/12) = 1.789772727 NES PPU (315/88) * (6/4) = 5.36931818
SN74LVC1404 Oscillator Driver for Crystal Oscillator or Ceramic Resonator SN74LVC1GX04 Crystal Oscillator Driver

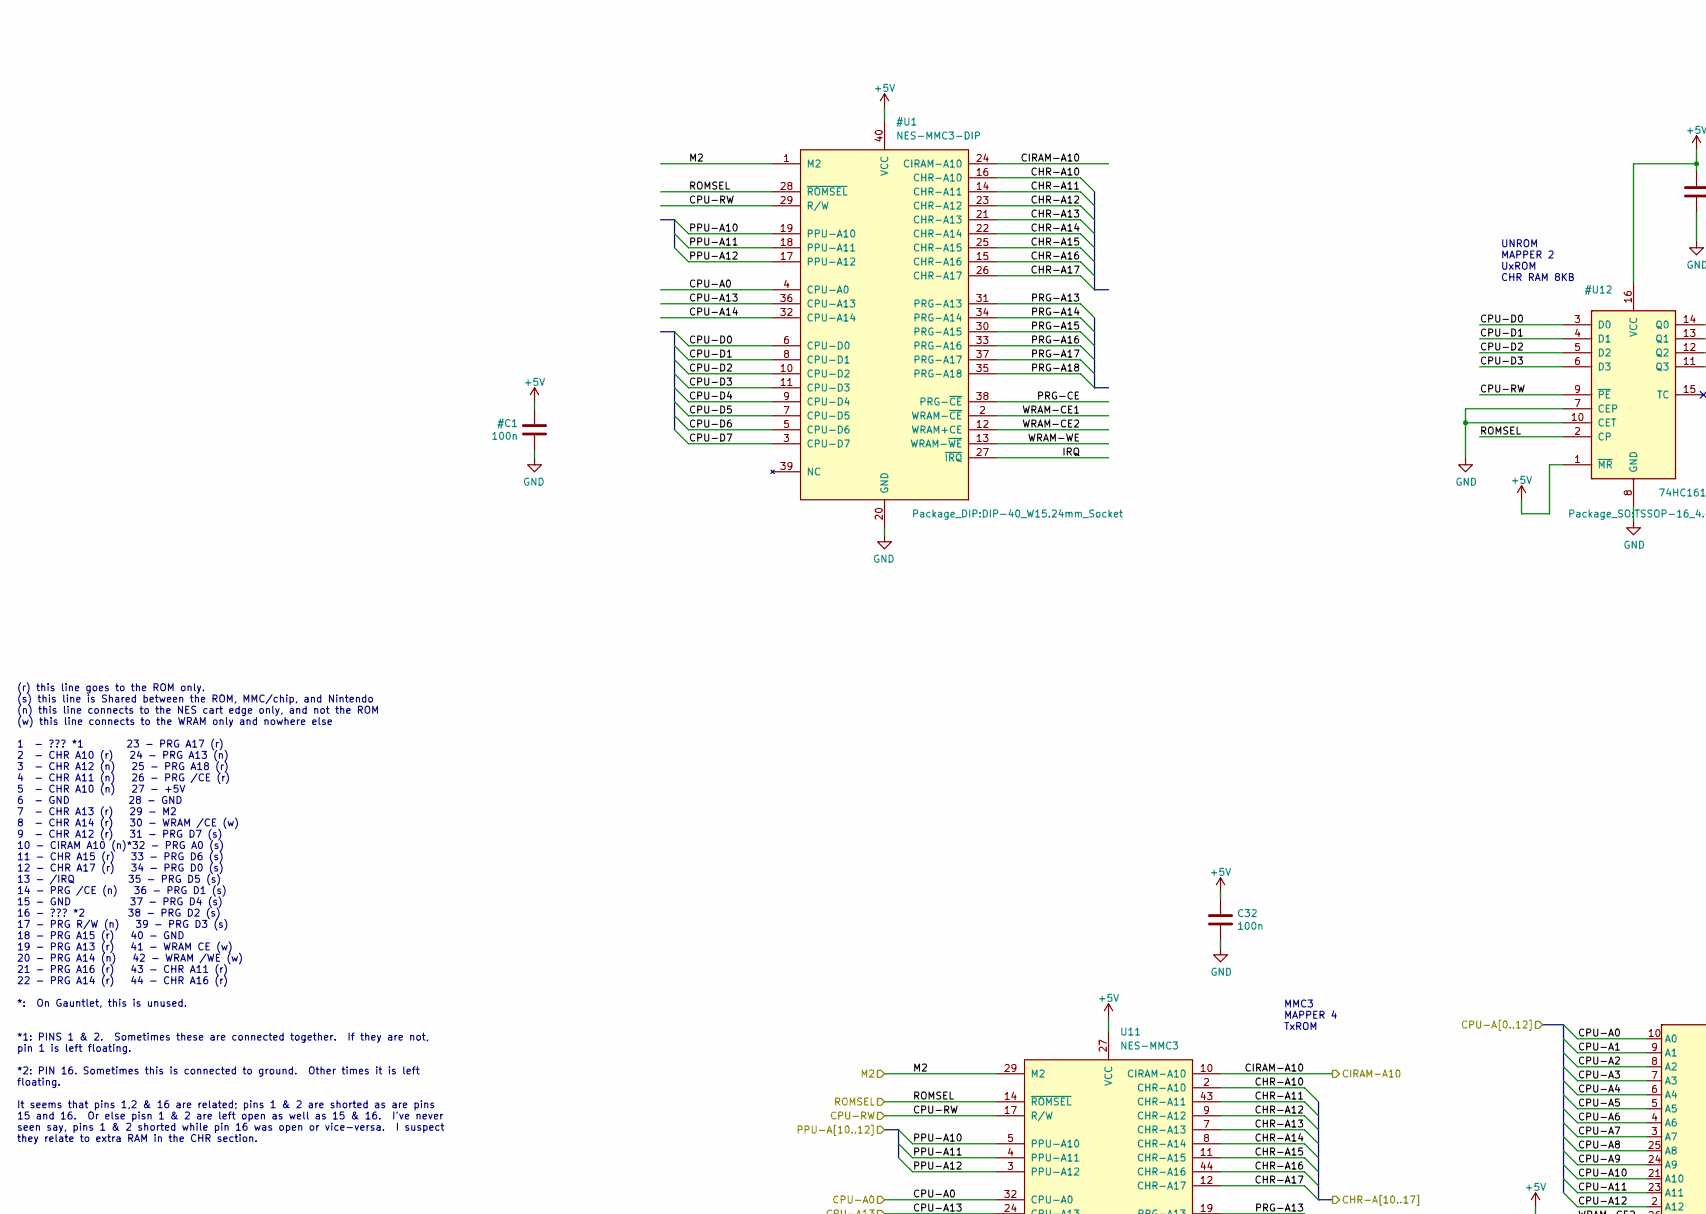
[picture p17: schematic MMC3.kicad_sch, InGame-NES MMC3, part in row 1, column 1]

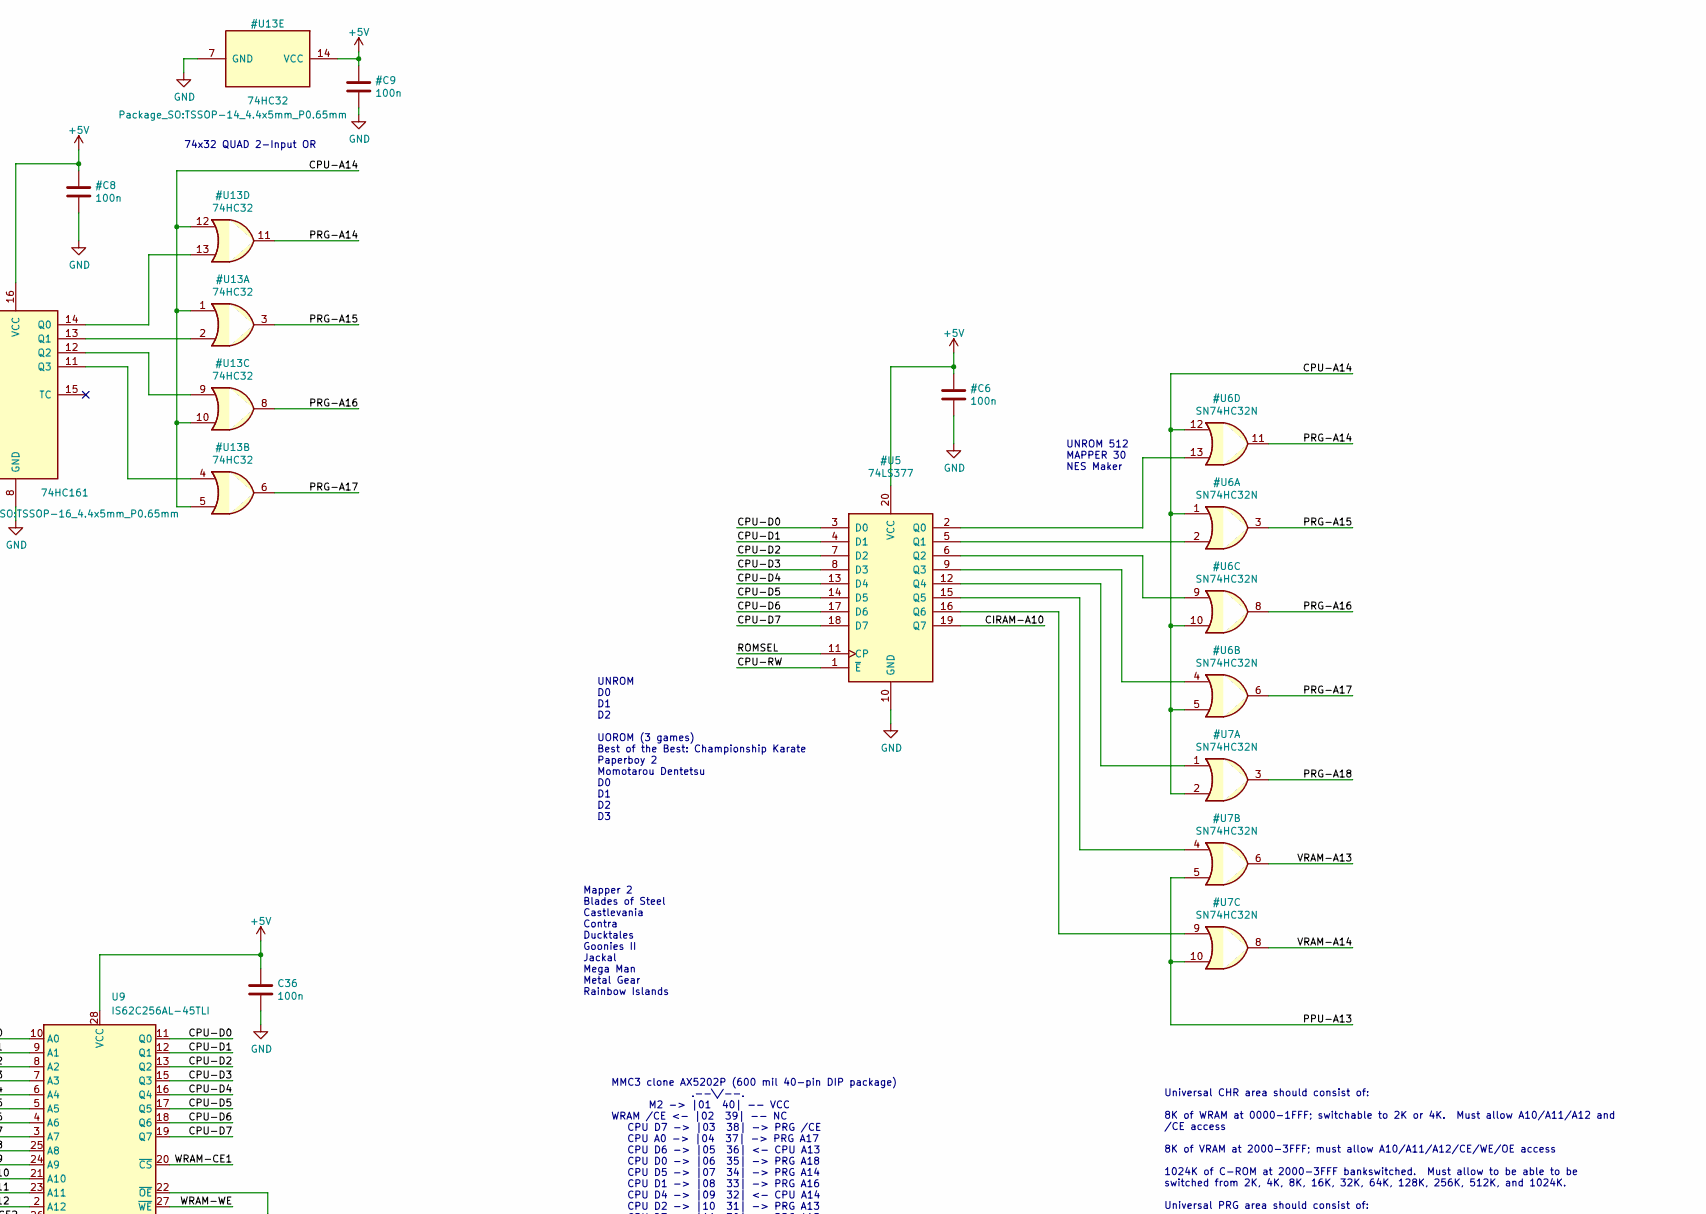
[picture p18: schematic MMC3.kicad_sch, InGame-NES MMC3, part in row 1, column 2]

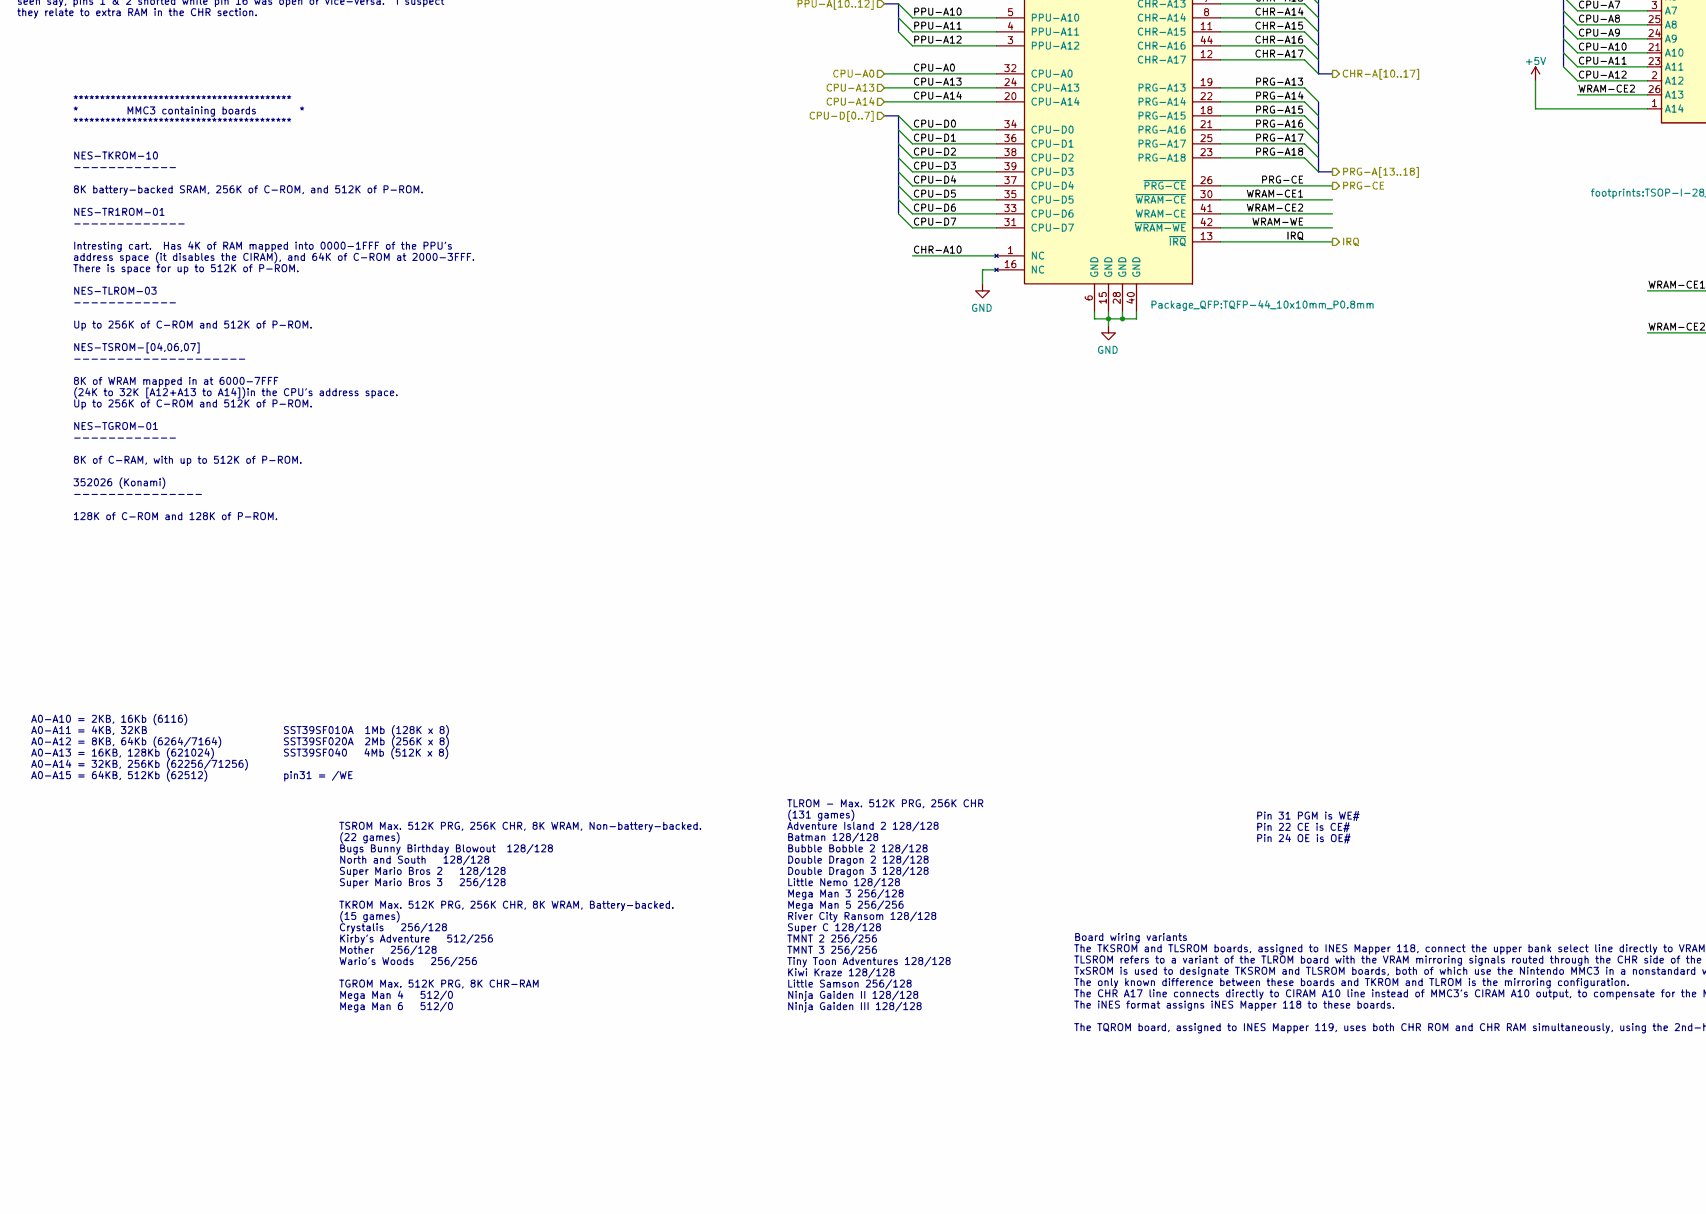
[picture p19: schematic MMC3.kicad_sch, InGame-NES MMC3, part in row 2, column 1]

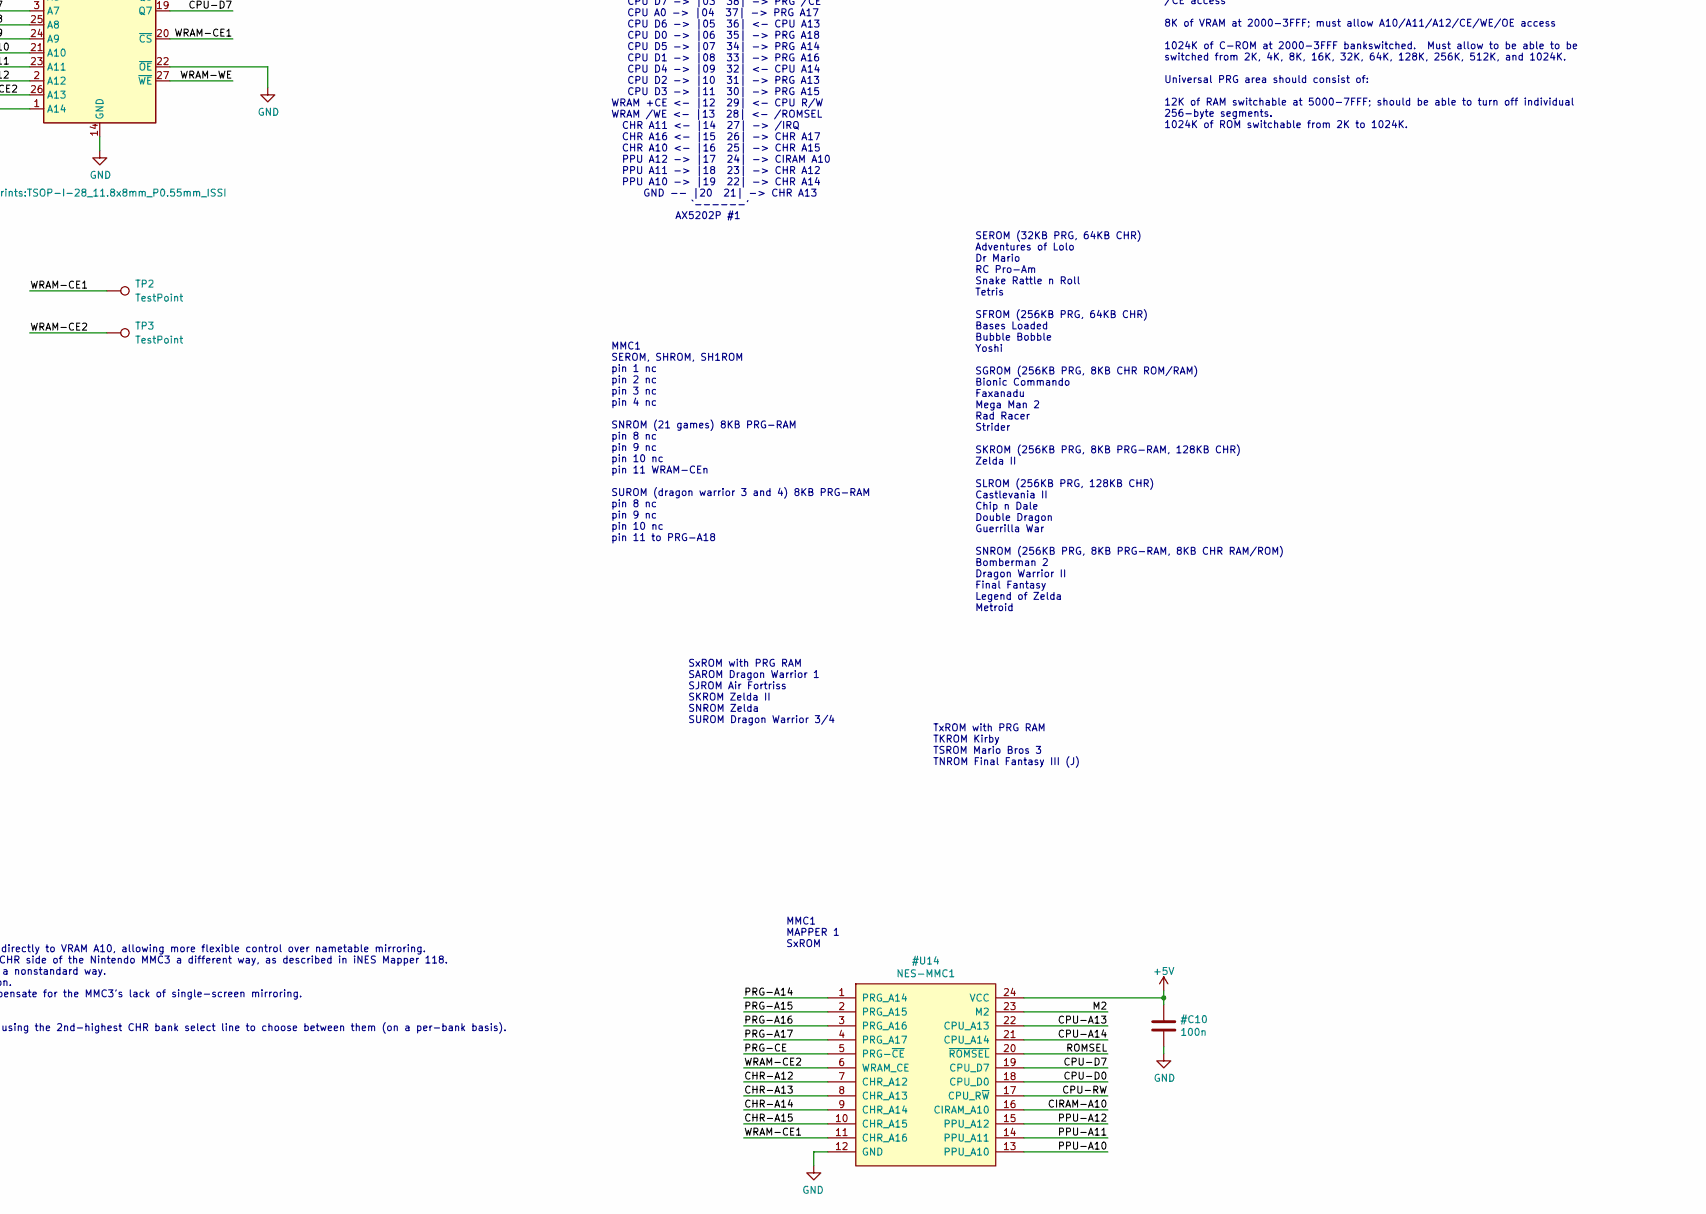
[picture p20: schematic MMC3.kicad_sch, InGame-NES MMC3, part in row 2, column 2]

Parts:
C32, C36: 100n; C_0402_1005Metric; MPN CL05B104KO5NNWC; Digikey 1276-1509-2-ND
TP2, TP3: TestPoint; TestPoint_Pad_D1.5mm
U9: IS62C256AL-45TLI; TSOP-I-28_11.8x8mm_P0.55mm_ISSI; MPN IS62C256AL-45TLI; Digikey 706-1109-ND
U11: NES-MMC3; TQFP-44_10x10mm_P0.8mm

Notes on the sheet:
SxROM with PRG RAM SAROM Dragon Warrior 1 SJROM Air Fortriss SKROM Zelda II SNROM Zelda SUROM Dragon Warrior 3/4
MMC1 SEROM, SHROM, SH1ROM pin 1 nc pin 2 nc pin 3 nc pin 4 nc SNROM (21 games) 8KB PRG-RAM pin 8 nc pin 9 nc pin 10 nc pin 11 WRAM-CEn SUROM (dragon warrior 3 and 4) 8KB PRG-RAM pin 8 nc pin 9 nc pin 10 nc pin 11 to PRG-A18
A0-A10 = 2KB, 16Kb (6116) A0-A11 = 4KB, 32KB A0-A12 = 8KB, 64Kb (6264/7164) A0-A13 = 16KB, 128Kb (621024) A0-A14 = 32KB, 256Kb (62256/71256) A0-A15 = 64KB, 512Kb (62512)
Universal CHR area should consist of: 8K of WRAM at 0000-1FFF; switchable to 2K or 4K. Must allow A10/A11/A12 and /CE access 8K of VRAM at 2000-3FFF; must allow A10/A11/A12/CE/WE/OE access 1024K of C-ROM at 2000-3FFF bankswitched. Must allow to be able to be switched from 2K, 4K, 8K, 16K, 32K, 64K,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
MMC3 clone AX5202P (600 mil 40-pin DIP package) .--\/--. M2 -> |01 40| -- VCC WRAM /CE <- |02 39| -- NC CPU D7 -> |03 38| -> PRG /CE CPU A0 -> |04 37| -> PRG A17 CPU D6 -> |05 36| <- CPU A13 CPU D0 -> |06 35| -> PRG A18 CPU D5 -> |07 34| -> PRG A14 CPU D1 -> |08 33| -> PRG A16 CPU D4 -> |09 32| <- 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
UNROM MAPPER 2 UxROM CHR RAM 8KB
SEROM (32KB PRG, 64KB CHR) Adventures of Lolo Dr Mario RC Pro-Am Snake Rattle n Roll Tetris SFROM (256KB PRG, 64KB CHR) Bases Loaded Bubble Bobble Yoshi SGROM (256KB PRG, 8KB CHR ROM/RAM) Bionic Commando Faxanadu Mega Man 2 Rad Racer Strider SKROM (256KB PRG, 8KB PRG-RAM, 128KB CHR) Zelda II SLROM 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
UNROM 512 MAPPER 30 NES Maker
TSROM Max. 512K PRG, 256K CHR, 8K WRAM, Non-battery-backed. (22 games) Bugs Bunny Birthday Blowout 128/128 North and South 128/128 Super Mario Bros 2 128/128 Super Mario Bros 3 256/128 TKROM Max. 512K PRG, 256K CHR, 8K WRAM, Battery-backed. (15 games) Crystalis 256/128 Kirby's Adventure 512/256 Mot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
TLROM - Max. 512K PRG, 256K CHR (131 games) Adventure Island 2 128/128 Batman 128/128 Bubble Bobble 2 128/128 Double Dragon 2 128/128 Double Dragon 3 128/128 Little Nemo 128/128 Mega Man 3 256/128 Mega Man 5 256/256 River City Ransom 128/128 Super C 128/128 TMNT 2 256/256 TMNT 3 256/256 Tiny Toon A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
MMC3 MAPPER 4 TxROM
TxROM with PRG RAM TKROM Kirby TSROM Mario Bros 3 TNROM Final Fantasy III (J)
SST39SF010A 1Mb (128K x 8) SST39SF020A 2Mb (256K x 8) SST39SF040 4Mb (512K x 8) pin31 = /WE
(r) this line goes to the ROM only. (s) this line is Shared between the ROM, MMC/chip, and Nintendo (n) this line connects to the NES cart edge only, and not the ROM (w) this line connects to the WRAM only and nowhere else 1 - ??? *1 23 - PRG A17 (r) 2 - CHR A10 (r) 24 - PRG A13 (n) 3 - CHR A12 (n)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
74x32 QUAD 2-Input OR
Pin 31 PGM is WE# Pin 22 CE is CE# Pin 24 OE is OE#
Mapper 2 Blades of Steel Castlevania Contra Ducktales Goonies II Jackal Mega Man Metal Gear Rainbow Islands
***************************************** * MMC3 containing boards * ***************************************** NES-TKROM-10 ------------ 8K battery-backed SRAM, 256K of C-ROM, and 512K of P-ROM. NES-TR1ROM-01 ------------- Intresting cart. Has 4K of RAM mapped into 0000-1FFF of the PPU's address sp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
Board wiring variants The TKSROM and TLSROM boards, assigned to INES Mapper 118, connect the upper bank select line directly to VRAM A10, allowing more flexible control over nametable mirroring. TLSROM refers to a variant of the TLROM board with the VRAM mirroring signals routed through the CHR sid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
MMC1 MAPPER 1 SxROM
UNROM D0 D1 D2 UOROM (3 games) Best of the Best: Championship Karate Paperboy 2 Momotarou Dentetsu D0 D1 D2 D3

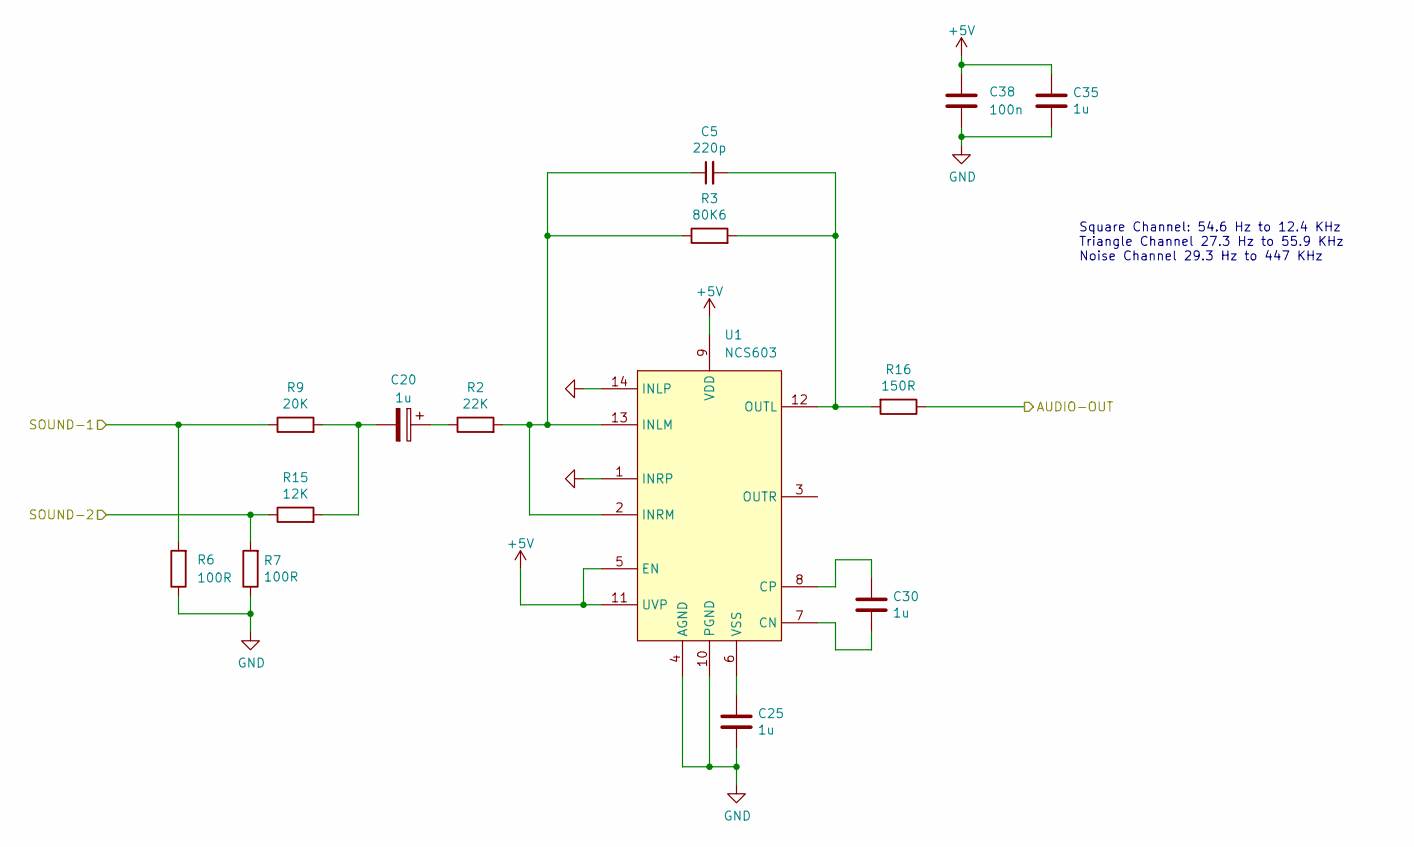
[picture p21: schematic audio.kicad_sch, InGame-NES MMC3]

Parts:
C5: 220p; C_0402_1005Metric; MPN CL05C221JB5NNNC; Digikey 1276-1059-1-ND
C20, C25, C30, C35: 1u; C_0402_1005Metric; MPN GRM155R61A105KE15D; Digikey 490-3890-2-ND
C38: 100n; C_0402_1005Metric; MPN CL05B104KO5NNWC; Digikey 1276-1509-2-ND
R2: 22K; R_0402_1005Metric; MPN RC0402FR-0722KL; Digikey 311-22.0KLRCT-ND
R3: 80K6; R_0402_1005Metric; MPN RC0402FR-0780K6L; Digikey 311-80.6KLRCT-ND
R6, R7: 100R; R_0402_1005Metric; MPN ERJ-2RKF1000X; Digikey P100LCT-ND
R9: 20K; R_0402_1005Metric; MPN RR0510P-203-D; Digikey RR05P20.0KDCT-ND
R15: 12K; R_0402_1005Metric; MPN RC0402FR-1312KL; Digikey 13-RC0402FR-1312KLCT-ND
R16: 150R; R_0603_1608Metric; MPN RC0603FR-07150RL; Digikey 311-150HRCT-ND
U1: NCS603; TSSOP-14_4.4x5mm_P0.65mm; MPN NCS603DTBR2G; Digikey NCS603DTBR2GOSCT-ND

Connections:
/AUDIO-OUT: R16.1; also elsewhere on the board
/Audio/SOUND-1: R6.2, R9.1; also elsewhere on the board
/Audio/SOUND-2: R7.2, R15.1; also elsewhere on the board
unnamed: C5.1, R2.2, R3.1, U1.2 (INRM), U1.13 (INLM)
unnamed: C5.2, R3.2, R16.2, U1.12 (OUTL)
unnamed: C20.1, R2.1
unnamed: C20.2, R9.2, R15.2
unnamed: C25.2, U1.6 (VSS)
unnamed: C30.1, U1.7 (CN)
unnamed: C30.2, U1.8 (CP)

Notes on the sheet:
Square Channel: 54.6 Hz to 12.4 KHz Triangle Channel 27.3 Hz to 55.9 KHz Noise Channel 29.3 Hz to 447 KHz

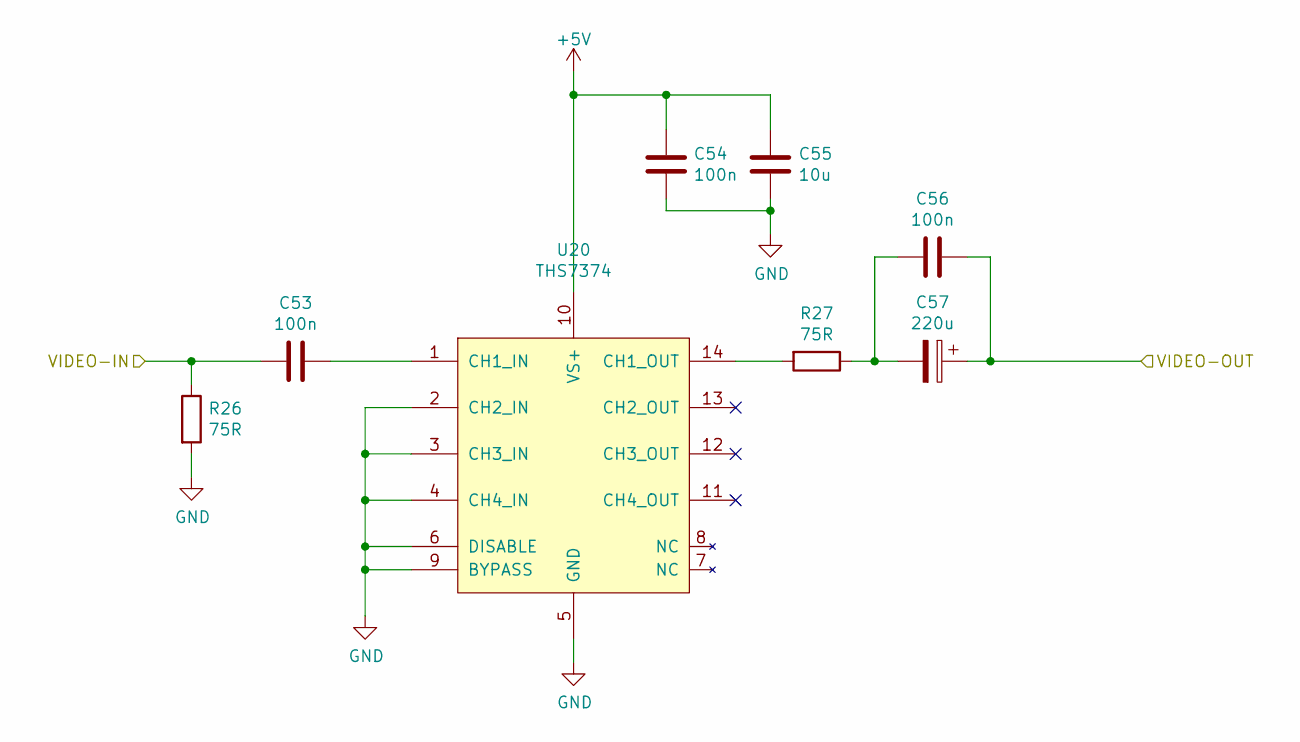
[picture p22: schematic video.kicad_sch, InGame-NES MMC3]

Parts:
C53, C54, C56: 100n; C_0402_1005Metric; MPN CL05B104KO5NNWC; Digikey 1276-1509-2-ND
C55: 10u; C_0805_2012Metric; MPN C0805C106K8PACTU; Digikey 399-4925-1-ND
C57: 220u; CP_EIA-7343-15_Kemet-W; MPN 593D227X9010D2TE3; Digikey 718-1105-1-ND
R26, R27: 75R; R_0402_1005Metric; MPN ERJ-2RKF75R0X; Digikey P75.0LCT-ND
U20: THS7374; TSSOP-14_4.4x5mm_P0.65mm; MPN THS7374IPWR; Digikey 296-41661-1-ND

Connections:
/PPU/VIDEO: C53.2, R26.1; also elsewhere on the board
/VIDEO-OUT: C56.1, C57.1; also elsewhere on the board
unnamed: C53.1, U20.1 (CH1_IN)
unnamed: C56.2, C57.2, R27.1
unnamed: R27.2, U20.14 (CH1_OUT)

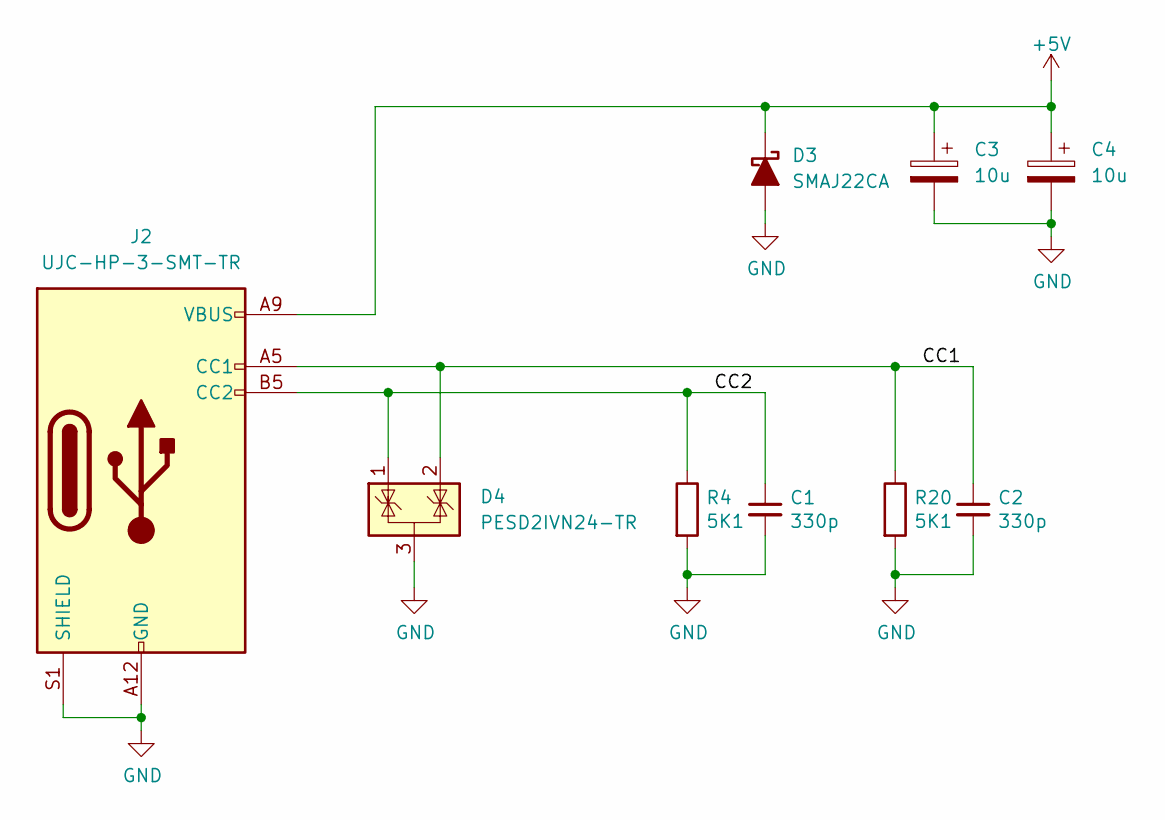
[picture p23: schematic USB-C.kicad_sch, InGame-NES MMC3]

Parts:
C1, C2: 330p; C_0402_1005Metric; MPN 0402N331J500CT; Digikey 1292-1308-1-ND
C3, C4: 10u; C_0805_2012Metric; MPN C0805C106K8PACTU; Digikey 399-4925-1-ND
D3: SMAJ22CA; D_SMA; MPN P4SMAJ22CAS_R1_00001; Digikey 3757-P4SMAJ22CAS_R1_00001CT-ND
D4: PESD2IVN24-TR; SOT-23; MPN DESD2CAN2SOQ-7; Digikey DESD2CAN2SOQ-7DICT-ND
J2: UJC-HP-3-SMT-TR; USB_C_Receptacle_CUI_UJC-HP-3-SMT-TR; MPN UJC-HP-3-SMT-TR; Digikey 2223-UJC-HP-3-SMT-CT-ND
R4, R20: 5K1; R_0402_1005Metric; MPN RC0402FR-075K1L; Digikey 311-5.10KLRCT-ND

Connections:
/USB-C-POWER/CC1: C2.1, D4.2 (K), J2.A5 (CC1), R20.1
/USB-C-POWER/CC2: C1.1, D4.1 (K), J2.B5 (CC2), R4.1

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
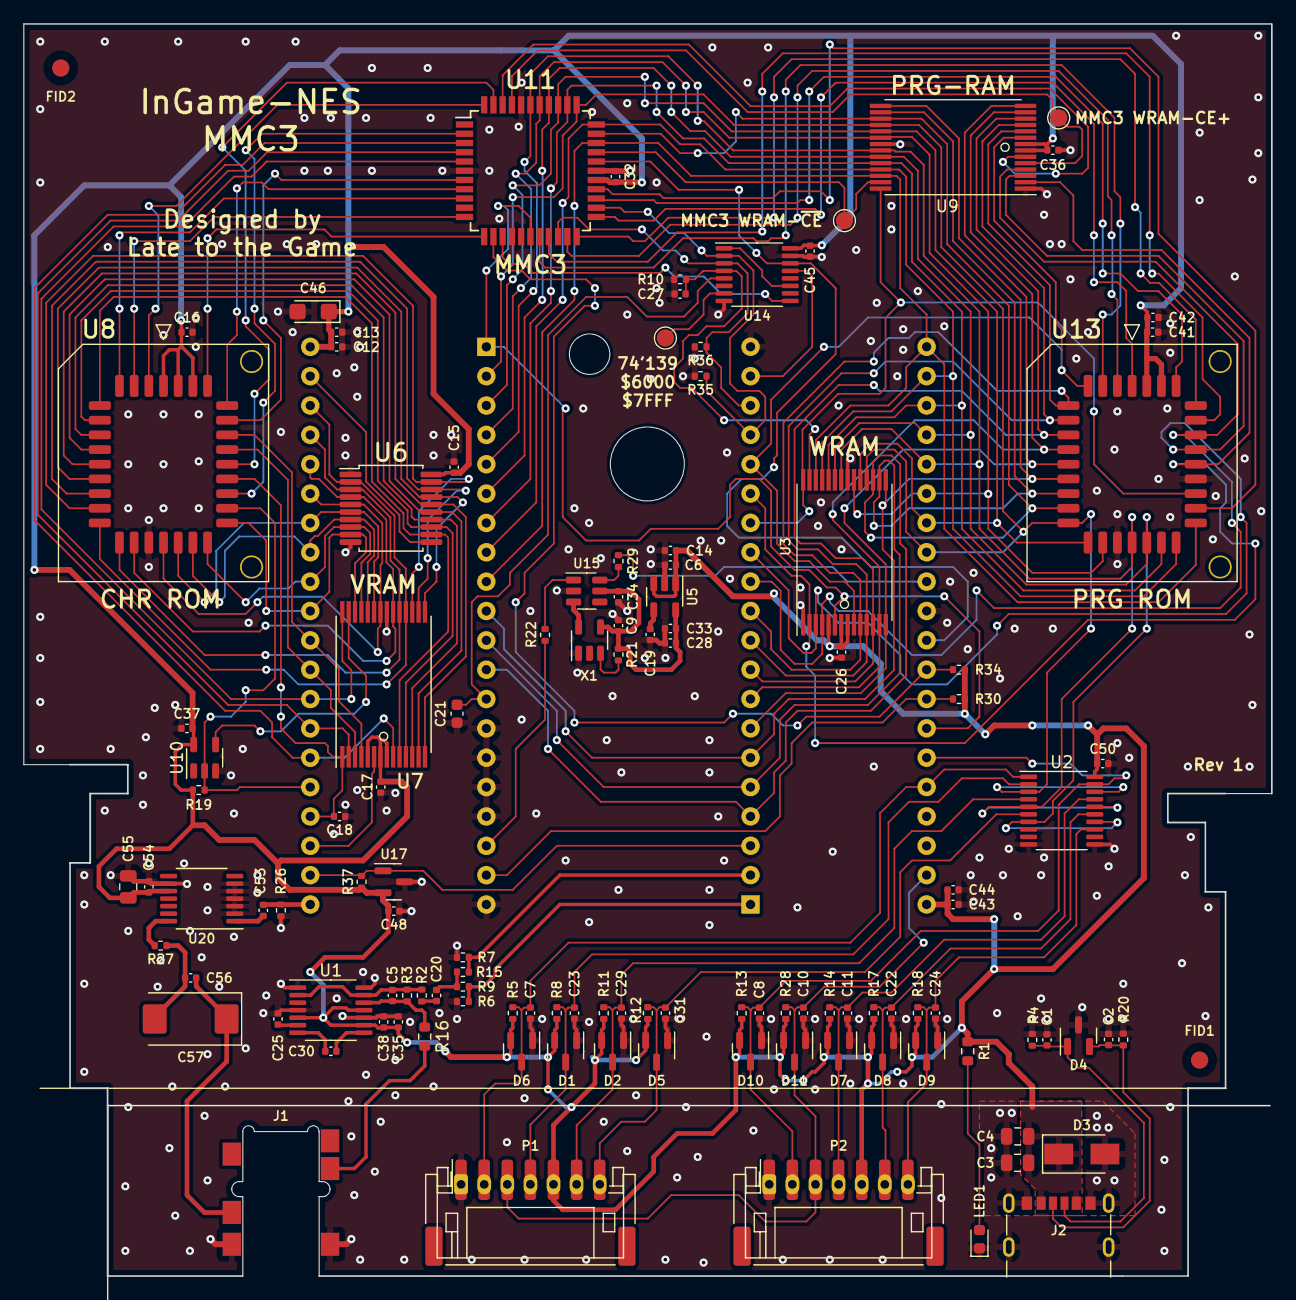
[picture p24: board ingameNES.kicad_pcb from above]

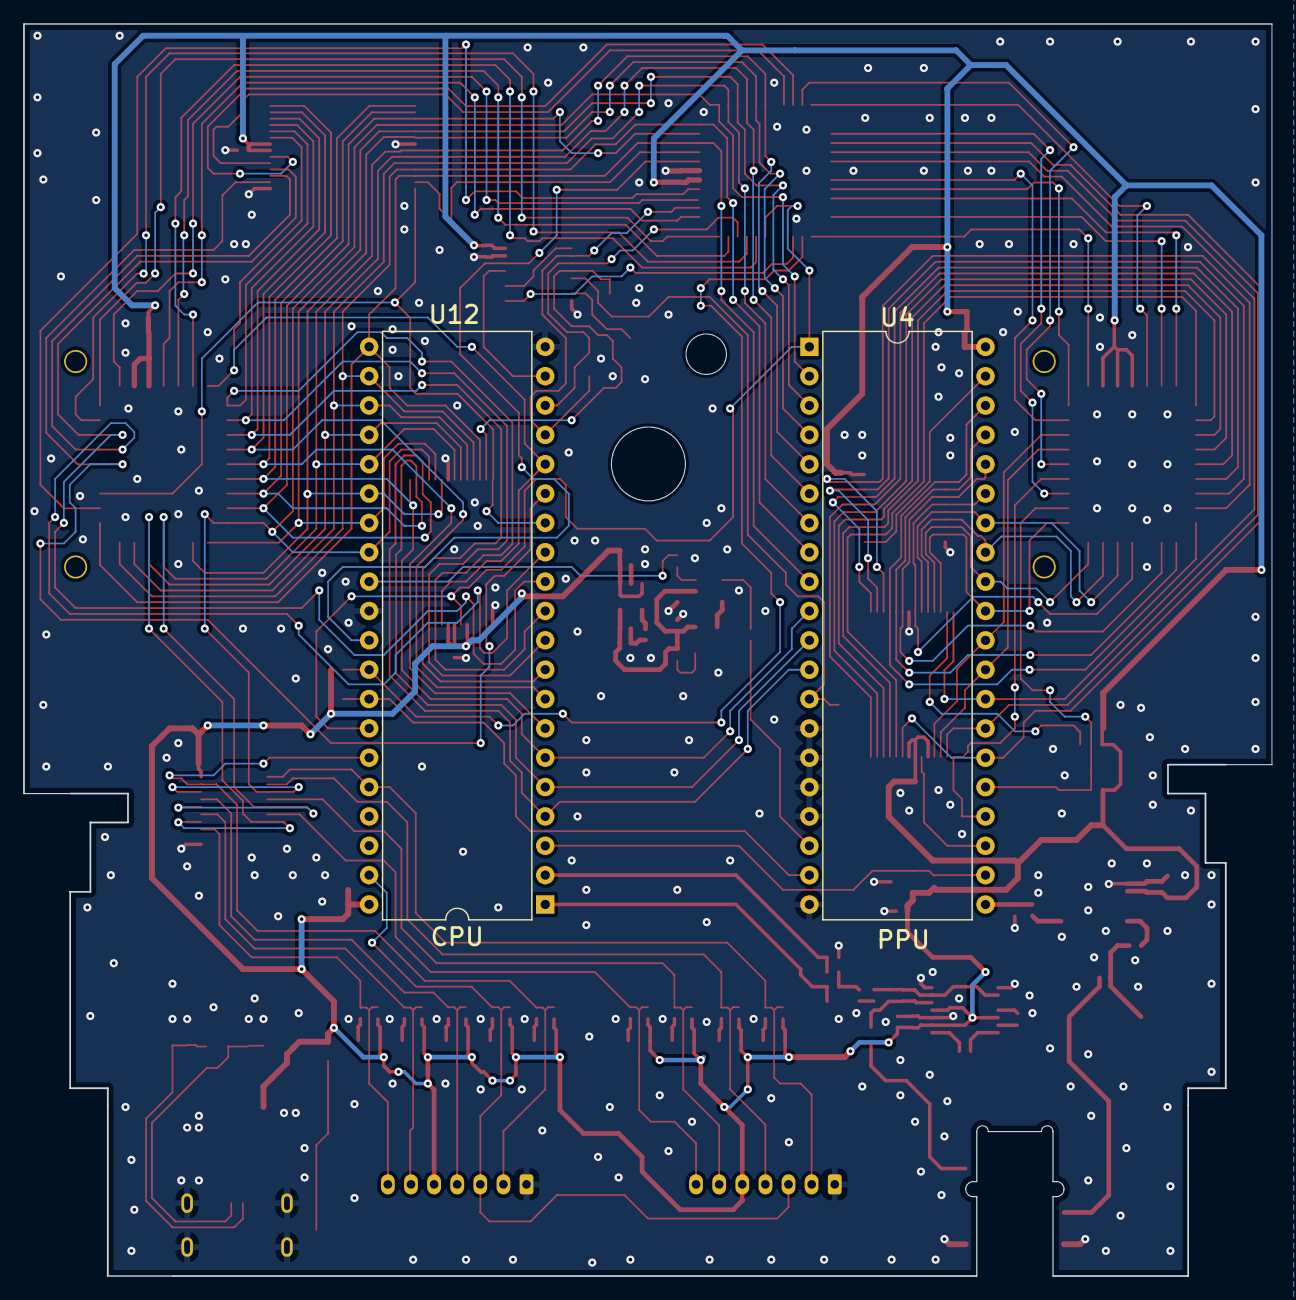
[picture p25: board ingameNES.kicad_pcb from below]

Board: 2 copper layers, 108.0 x 108.3 mm, 125 parts (2 on the bottom side), 115 nets.
