LateToTheGame16/InGameNES/(commit log)

2022-06-28 first fab sent out
    [8432-21a1-01.stp, CLOCK.kicad_sch, CPU.kicad_sch, CUI_DEVICES_SJ-43504-SMT-TR.step, CUI_UJC-HP-3-SMT-TR.step, INPUT.kicad_sch, MMC3.kicad_sch, PPU.kicad_sch]
2022-07-29 rev2 sent to fab
    Added CHR RAM.
    Changed board to 4 layers (was 2 layers).
    Changed passives to 0603 (was 0402)
    Fixed CIRAM-A10 not being hooked up
    Fixed PPU-A10..A12 being hooked to VRAM but should have been.
    Added more silkscreen for easier debugging.
    Added filter inductor to 5V from USB-C.
    Changed video out to stock (was THS7374)
    Changed audio circuit to stock (was headphone amp IC)
    [CLOCK.kicad_sch, CPU.kicad_sch, INPUT.kicad_sch, L_XNH8080YK.STEP, MMC3.kicad_sch, PPU.kicad_sch, PTS847MM350LSMTR2 LFS.stp, USB-C.kicad_sch]
2022-08-04 filled out BOM
    [CLOCK.kicad_sch, CPU.kicad_sch, INPUT.kicad_sch, MMC3.kicad_sch, PPU.kicad_sch, USB-C.kicad_sch, audio.kicad_sch, ingameNES.kicad_sch]
2022-08-10 InGameNES rev 2.1
    Change AV pinout to CTIA standard. Mono audio goes to R and L channels. Video now pinned to sleeve so its yellow on 3RCA breakout.
    -Added boundary rule so copper fills do not bridge pins. The bridges were on SRAM near capacitors. It is electrically correct but it looks wrong for QA.
    [CLOCK.kicad_sch, CPU.kicad_sch, INPUT.kicad_sch, MMC3.kicad_sch, PPU.kicad_sch, USB-C.kicad_sch, audio.kicad_sch, ingameNES.kicad_sch]
