LateToTheGame16/InGameNES/(notices)

Notices in the files:
PTS847MM350LSMTR2 LFS.stp:
FILE_NAME( 'C:/Users/KMIROS~1/AppData/Local/Temp/psolqas_18160_0.stp', '2021-04-14T07:56:49', ( 'License CC BY-ND 4.0' ), ( 'CADENAS' ), ' ', 'PARTsolutions', ' ' );
